WattRex/Regenerative-Battery-Cycler/doc/Sys_requirements.xlsm

Sheet: Info
Document Info
Internal project name | EPC - Electronic Power Converter for battery cycling
Filename | Sys_requirements_v7
Owner | Pablo Pastor
Review date | 2023-05-30
Review history | V6: - First versions from @Iulian in spanish translated and reviewed - Interal links between SYS // SW // HW Reqs added V7: - SW_reqs initialized - Registers included - SYS026 HS min value changed to 5v4 - SYS041, SYS042 changed to -15, 65 ºC - SYS045, SYS046 changed to -15, 65 ºC - SYS049, SYS050 changed to -15, 65 ºC - SYS043, SYS047, SYS051 changed to +-0.5 - resolution changed to accuracy - limit for wait only time

Sheet: Acronyms
Acronyms definition
EPC | Electronic Power Converter
HS | High Side (Input of the EPC with higher voltage)
LS | Low Side (Input of the EPC with lower voltage)
DUT | Device Under Test (Battery connected in LS)
SOA | Safe Operative Area

Sheet: SYS_Req
Requirement list
 |  |  |  |  |  |  | Category List | Functional | Technical | Operational | KPI | Transitional
Category | ID | Req. Description | Category | Priority | Test or verification | Derivated | Priority list | Must have | Should have | Could have | Won't have
General | SYS001 | The main target besides all the technical and functional requirements descripted here is the lowest cost possible | KPI | Must have |  | ,
General | SYS002 | The device is able to charge and discharge a DUT connected to the LS of the EPC | Functional | Must have
General | SYS003 | The electronics in the EPC powers from the HS input power system | Technical | Must have |  | ,
General | SYS004 | The stand-by power consumtion is lower than XXX mW | Technical | Must have |  | ,
General | SYS005 | The efficiency of the EPC goes up to XXX % | Technical | Must have
General | SYS006 | The EPC follows a bidirectional synchronous buck topology | Technical | Must have | - | ,
Mechanical | SYS007 | The EPC should fit in a box with maximum dimensions of 15x15x5 cm | Functional | Must have | - | ,
Mechanical | SYS008 | The EPCs must be interconectable to stack mechanically several devices (up to, at least, 10) | Functional | Must have |  | ,
Mechanical | SYS009 | The EPC has different DUT ports models (battery holder and external). This must lead to few changes in the construction of the device | Functional | Must have
Mechanical | SYS010 | The EPC has a 18650 battery holder to connect the DUT | Functional | Must have |  | ,
Mechanical | SYS011 | The EPC has a banana plug to connect external DUT | Functional | Could have |  | ,
Measures | SYS012 | The EPC has an external voltage measurement conector to sense voltage with a 4 point probe | Functional | Must have |  | ,
Measures | SYS013 | The EPC has an external NTC probe to measure ambient temperature | Functional | Must have |  | ,
Measures | SYS014 | The EPC has an external NTC probe in the anode of the 18650 battery holder | Functional | Must have |  | ,
Measures | SYS015 | The EPC has an integrated temperature probe in the body of the 18650 battery holder | Functional | Must have |  | ,
Measures | SYS016 | The EPC has an external NTC probe to measure the external DUT temperature | Functional | Could have |  | ,
Measures | SYS017 | The external NTC probe for the anode could be moved to the anode of an external DUT | Functional | Could have |  | ,
Measures | SYS018 | The EPC measures HS voltage | Functional | Must have |  | ,
Measures | SYS019 | The EPC measures LS voltage | Functional | Must have |  | ,
Measures | SYS020 | The EPC measures LS current | Functional | Must have |  | ,
Measures | SYS021 | The measurement of the LS voltage is allways made via a 4 points system (in battery holder as well as in external batteries) | Technical | Must have |  | ,
Measures | SYS022 | The system monitorizes internal temperature to avoid over temperature while working | Technical | Must have |  | ,
HS V def | SYS023 | The maximum limit to measure HS voltage is 15 V | Technical | Must have |  | ,
HS V def | SYS024 | The minimum limit to measure HS voltage is 0 V | Technical | Must have |  | ,
HS V def | SYS025 | The maximum operative voltage in HS (overvoltage alarm) is 14 V | Technical | Must have |  | SW001,
HS V def | SYS026 | The minimum operative voltage in HS (undervoltage alarm) is 5.4 V | Technical | Must have |  | SW001,
HS V def | SYS027 | The accuracy in the HS voltage measurement is ± 5 mV | Technical | Must have |  | ,
HS V def | SYS028 | The sampling rate for the HS voltage signal is 100 kHz (10 us) | Technical | Must have |  | ,
LS V def | SYS029 | The maximum limit to measure LS voltage is 6 V | Technical | Must have |  | ,
LS V def | SYS030 | The minimum limit to measure LS voltage is 0 V | Technical | Must have |  | ,
LS V def | SYS031 | The maximum operative voltage in LS (overvoltage alarm) is 5 V | Technical | Must have |  | SW002,
LS V def | SYS032 | The minimum operative voltage in LS (undervoltage alarm) is 0.5 V | Technical | Must have |  | SW002,
LS V def | SYS033 | The accuracy in the LS voltage measurement is ± 5 mV | Technical | Must have |  | ,
LS V def | SYS034 | The sampling rate for the LS voltage signal is 100 kHz (10 us) | Technical | Must have |  | ,
LS I def | SYS035 | The maximum limit to measure LS current is +16.5 A | Technical | Must have |  | ,
LS I def | SYS036 | The minimum limit to measure LS current is -16.5 A | Technical | Must have |  | ,
LS I def | SYS037 | The maximum controlable current in LS (control limit) is 15 A | Technical | Must have |  | SW003,
LS I def | SYS038 | The minimum controlable current in LS (control limit) is -15 A | Technical | Must have |  | SW003,
LS I def | SYS039 | The accuracy in the LS current measurement is ± 10 mA | Technical | Must have |  | ,
LS I def | SYS040 | The sampling rate for the LS current signal is 100 kHz (10 us) | Technical | Must have |  | ,
Temp amb | SYS041 | The maximum limit to measure ambient temperature is +65 ºC | Technical | Must have |  | SW004,
Temp amb | SYS042 | The minimum limit to measure ambient temperature is -15 ºC | Technical | Must have |  | SW004,
Temp amb | SYS043 | The accuracy in the ambient temperature is ± 0.5 ºC | Technical | Should have |  | ,
Temp amb | SYS044 | The sampling rate for the ambient temperature signal is 1 Hz (1 s) | Technical | Must have |  | ,
Temp body | SYS045 | The maximum limit to measure body temperature is +65 ºC | Technical | Must have |  | ,
Temp body | SYS046 | The minimum limit to measure body temperature is -15 ºC | Technical | Must have |  | ,
Temp body | SYS047 | The accuracy in the body temperature is ± 0.5 ºC | Technical | Should have |  | ,
Temp body | SYS048 | The sampling rate for the body temperature signal is 1 Hz (1 s) | Technical | Must have |  | ,
Temp anode | SYS049 | The maximum limit to measure anode temperature is +65 ºC | Technical | Must have |  | SW005,
Temp anode | SYS050 | The minimum limit to measure anode temperature is -15 ºC | Technical | Must have |  | SW005,
Temp anode | SYS051 | The accuracy in the anode temperature is ± 0.5 ºC | Technical | Should have |  | ,
Temp anode | SYS052 | The sampling rate for the anode temperature signal is 1 Hz (1 s) | Technical | Could have |  | ,
Control | SYS053 | The EPC has a control mode in current of LS: CC | Functional | Must have |  | ,
Control | SYS054 | The EPC has a control mode in voltage of LS: CV | Functional | Must have |  | ,
Control | SYS055 | The EPC has a control mode in power of LS: CP | Functional | Must have |  | ,
Control | SYS056 | The EPC has a control mode disabling the DMOS, with zero current in LS: WAIT | Functional | Must have |  | ,
Control | SYS057 | The EPC will apply the reference if the output is enabled until the setted limit is reached, the output is disabled or a new reference value is applied | Functional | Must have
Control | SYS058 | When the limit is reached or the output is disabled, the new defauls state will be IDLE
Control | SYS059 | The minimum control step for the reference and limit values are 1 mA // mV // dW // ms | Functional | Must have |  | ,
Control | SYS060 | The current reference range is the same as the controlable current range | Functional | Must have |  | ,
Control | SYS061 | The voltage reference range is the same as the operative LS voltage | Functional | Must have |  | ,
Control | SYS062 | Time limit reference minimum value is 1 ms
Control | SYS063 | Time limit reference maximum value is 4294967295 ms (3 days)
Control | SYS064 | Time limit reference resolution is 1 ms
Control | SYS065 | The power reference range is ± 50 W | Functional | Must have |  | ,
Control | SYS066 | The SOA is defined by the maximum and minimum controlable LS current and operative LS voltage | Functional | Must have |  | ,
Control | SYS067 | If reference exceeds SOA, the reference will be limited to be in the SOA | Functional | Must have |  | ,
Control | SYS068 | The maximum LS current ripple in best case scenario is ± 10 mA | Functional | Should have |  | ,
Control | SYS069 | The maximum LS voltage ripple in best case scenario is ± 10 mV | Functional | Should have |  | ,
Control | SYS070 | The maximum LS power ripple in best case scenario is ± 5 mW | Functional | Must have |  | ,
Control | SYS071 | The maximum response time in best case scenario is 1 ms (1 kHz) | Functional | Must have |  | ,
Control | SYS072 | The maximum response time is 10 ms (100 Hz) | Functional | Must have |  | ,
Control | SYS073 | The possible limits for voltage control mode are time, current or power | Functional | Must have |  | ,
Control | SYS074 | The possible limits for current control mode are time, voltage or power | Functional | Must have |  | ,
Control | SYS075 | The possible limits for power control mode are time, current or voltage | Functional | Must have |  | ,
Control | SYS076 | The possible limit for wait mode is only time | Functional | Must have |  | ,
Control | SYS077 | Enable signal, mode, reference, limit and limit reference are send together | Functional | Must have |  | SW008,
Interface | SYS078 | The EPC has a CAN bus communication system | Technical | Must have |  | ,
Interface | SYS079 | The EPC has several LEDs to indicate function mode and errors | Functional | Should have |  | ,
Interface | SYS080 | Each mode and error has a different combination of LEDs blinks to be identified | Functional | Should have
Interface | SYS081 | The user will set the output (enable or disable) via CAN | Functional | Must have |  | ,
Interface | SYS082 | The user will set the control mode via CAN | Functional | Must have |  | ,
Interface | SYS083 | To each message without response request, the EPC will response with the register updated to check signal integrity, if there is an error in the message the values won´t be updated. | Functional | Must have
Limits | SYS084 | The user can change the software alarms for LS maximum voltage between the operative range via CAN | Functional | Must have |  | ,
Limits | SYS085 | The user can change the software alarms for LS minimum voltage between the operative range via CAN | Functional | Must have |  | ,
Limits | SYS086 | The user can change the software alarms for LS maximum current between the controlable range via CAN | Functional | Must have |  | ,
Limits | SYS087 | The user can change the software alarms for LS minimum current between the controlable range via CAN | Functional | Must have |  | ,
Limits | SYS088 | The user can change the software alarms for HS maximum voltage between the operative range via CAN | Functional | Must have |  | ,
Limits | SYS089 | The user can change the software alarms for HS minimum voltage between the operative range via CAN | Functional | Must have |  | ,
Limits | SYS090 | The user can change the software alarms for HS maximum current between the controlable range via CAN | Functional | Could have |  | SW006,
Limits | SYS091 | The user can change the software alarms for HS minimum current between the controlable range via CAN | Functional | Could have |  | SW006,
Limits | SYS092 | The user can change the software alarms for LS maximum power between the operative range via CAN | Functional | Must have |  | ,
Limits | SYS093 | The user can change the software alarms for LS minimum power between the operative range via CAN | Functional | Must have
Limits | SYS094 | The user can change the software alarms for maximum temperature (in any temperature sensor) | Functional | Must have
Limits | SYS095 | The user can change the software alarms for minimum temperature (in any temperature sensor) | Functional | Must have |  | ,
Limits | SYS096 | The user can ask for every limit to check its actual value | Functional | Must have
Msg req | SYS097 | The user can request the device ID to the device via CAN | Functional | Should have
Msg req | SYS098 | The user can request the firmware version to the device via CAN | Functional | Should have
Msg req | SYS099 | The user can request the hardware version to the device via CAN | Functional | Should have
Msg req | SYS100 | The user can request the LS Voltage via CAN | Functional | Must have
Msg req | SYS101 | The user can request the LS Current via CAN | Functional | Must have
Msg req | SYS102 | The user can request the HS Voltage via CAN | Functional | Must have
Msg req | SYS103 | The user can request the Body temperature via CAN | Functional | Must have
Msg req | SYS104 | The user can request the Anode temperature via CAN | Functional | Must have
Msg req | SYS105 | The user can request the Ambient temperature via CAN | Functional | Must have
Periodic msg | SYS106 | The user can enable or disable a heart beat message (from the user to the EPC). If not received in the stablished period, it will disable the power flow | Functional | Must have
Periodic msg | SYS107 | The user can set the period of the heart beat message from the user to the EPC | Functional | Must have |  | ,
Periodic msg | SYS108 | The user can enable or disable a periodical request of the electrical variables | Functional | Must have |  | ,
Periodic msg | SYS109 | The user can set the period of the electrical variables message | Functional | Must have |  | ,
Periodic msg | SYS110 | The user can enable or disable a periodical request of the temperature variables | Functional | Must have |  | ,
Periodic msg | SYS111 | The user can set the period of the temperature variables message | Functional | Must have |  | ,
Error | SYS112 | The EPC has a LS current error detection: It detects LS current out of the controlable range and disable the output | Functional | Must have |  | ,
Error | SYS113 | The EPC has a LS voltage error detection: It detects LS voltage out of the operative range and disable the output | Functional | Must have |  | ,
Error | SYS114 | The EPC has a HS voltage error detection: It detects LS voltage out of the operative range and disable the output | Functional | Must have |  | ,
Error | SYS115 | The EPC has a temperature error detection: It detects temperature (in any sensor) out of the operative range and disable the output | Functional | Must have |  | ,
Error | SYS116 | The EPC has a communications error: It detects errors in the CAN bus. If the user heart beat is enabled and the heart beat is not sended in the stablished period, this error is rised & the output is disabled | Functional | Must have |  | ,
Error | SYS117 | The EPC has a internal error signal: Any internal error (temperature, devices status, software issues) will be detected and the output will be disabled | Functional | Must have |  | ,
Error | SYS118 | The EPC will send a message via CAN when any error is raised indicating the error type and error value | Functional | Must have |  | ,
Error | SYS119 | The EPC will set a binary code in the LEDs to indicate the error to the user | Functional | Should have |  | ,
Error | SYS120 | When any error is enabled, the device will not accept new references nor consign limits | Functional | Must have |  | ,
Error | SYS121 | Security limits can be changed in any error mode | Functional | Must have |  | ,
Control | SYS122 | The status after all errors are cleared will be IDLE without any consign | Functional | Must have |  | ,
Error | SYS123 | The HS voltage error will be cleared when the levels are back to the defined limit range | Functional | Must have |  | ,
Error | SYS124 | The LS voltage error will be cleared when the levels are back to the defined limit range | Functional | Must have |  | ,
Error | SYS125 | The LS current error will be cleared when the levels are back to the defined limit range | Functional | Must have |  | ,
Error | SYS126 | The temperature error will be cleared when the levels are back to the defined limit range | Functional | Must have |  | ,
Control | SYS127 | The internal error might be self-cleared if any internal routine is able to fix the issue. If not, the device must be power off and on | Functional | Must have |  | ,
Error | SYS128 | The communication error will be cleared when a user message is succesfully received | Functional | Must have |  | ,

Sheet: SW_Req
Requirement list
Category | ID | Related to | Req. Description | Affects | Derivated
Limits | SW001 | SYS025, SYS026 | Internal limit for limit range in HS voltage goes from [5.3 … 14.1] V to include max and min SYS defined values in range | - Limit ranges - Registers
Limits | SW002 | SYS031, SYS032 | Internal limit for limit range in LS voltage goes from [0.4 … 5.1] V to include max and min SYS defined values in range | - Limit ranges - Registers
Limits | SW003 | SYS037, SYS038 | Internal limit for limit range in LS current goes from [-15.1 … 15.1] A to include max and min SYS defined values in range | - Limit ranges - Registers
Limits | SW004 | SYS041, SYS042 | Internal limit for limit range in ambient temp goes from [-20 … 70] ºC to include max and min SYS defined values in range | - Limit ranges - Registers | HW001
Limits | SW005 | SYS049, SYS050 | Internal limit for limit range in anode temp goes from [-20 … 70] ºC to include max and min SYS defined values in range | - Limit ranges - Registers | HW001
Limits | SW006 | SYS090, SYS091 | Limits in HS Current WON'T BE IMPLEMENTED | - Limit ranges - Registers - CAN Messages
Error | SW007 | - | Watchdog reset uC after 0.5 ms if not hearbeat received | - APP_SALG - HAL_WDG
Interface | SW008 | SYS077 | The maximum response time for communication is 10 ms (100 Hz) | - APP_IFACE
 | SW009
 | SW010
 | SW011
 | SW012
 | SW013
 | SW014
 | SW015
 | SW016
 | SW017
 | SW018
 | SW019
 | SW020
 | SW021

Sheet: HW_Req
Requirement list
Category | ID | Related to | Req. Description | Affects | Derivated
Measures | HW001 | SYS041, SYS042, SYS049, SYS050, SW004, SW005 | Hardware limits to temperature measurements in ADC are [-20 … 70] ºC to have more software range | - NTC to 3v3 conversion
Power | HW002 | - | Fast blow fuse connected in positive input: - 10A continuous 2.7h to blow - 20A continuous 100ms to blow
Temp control | HW003 | - | Add a GPIO to a transistor to activate an external fan
 | HW004
 | HW005
 | HW006
 | HW007
 | HW008
 | HW009
 | HW010
 | HW011
 | HW012
 | HW013
 | HW014
 | HW015
 | HW016
 | HW017
 | HW018
 | HW019
 | HW020
 | HW021
 | HW022
 | HW023
 | HW024
 | HW025 |  | min -20
 | HW026 |  | max 70
 | HW027
 | HW028
 | HW029
 | HW030
 | HW031
 | HW032
 | HW033
 | HW034
 | HW035
 | HW036
 | HW037
 | HW038
 | HW039
 | HW040
 | HW041
 | HW042
 | HW043
 | HW044
 | HW045
 | HW046
 | HW047
 | HW048
 | HW049
 | HW050
 | HW051
 | HW052
 | HW053
 | HW054
 | HW055
 | HW056
 | HW057
 | HW058
 | HW059
 | HW060
 | HW061
 | HW062
 | HW063
 | HW064
 | HW065
 | HW066
 | HW067
 | HW068
 | HW069
 | HW070
 | HW071
 | HW072
Signals
 | From |  | Signal | Direction | Resolution | Resolution |  | Range
SG_SW001 | SYS007 |  | V_HS | Input | SYS029 | SYS029 | 4mV | SYS025,SYS026 | 7-15V
SG_SW002 | SYS008 |  | V_LS | Input | SYS034 | SYS034 | 1,5mV | SYS030,SYS031
SG_SW003 | SYS010 |  | I_LS | Input | SYS039 | SYS039 | 5,5mA | SYS037,SYS038
SG_SW004 | SYS011 |  | V_LS_ext | Input | SYS034 | SYS034 | 1,5mV | SYS030,SYS031
SG_SW005 | SYS012 |  | T_HS | Input | SYS017 | SYS017 | XXX bits | SYS015 | 15-55
SG_SW006 | SYS013 |  | T_LS_an | Input | SYS020 | SYS020 | XXX bits | SYS018 | 15-55
SG_SW007 | SYS021 |  | V_5v | Input
SG_SW008 | SYS004 |  | V_3v3 | Input
SG_SW009 | SYS014 |  | T_LS_bo | Input | SYS001 | SYS001 | XXX bits | SYS089 | 0-65
SG_SW010 | SYS022 |  | Led_1 | Output
SG_SW011 | SYS022 |  | Led_2 | Output
SG_SW012 | SYS022 |  | Led_3 | Output
SG_SW013 | SYS022 |  | Led_4 | Output
SG_SW014 | SYS046 |  | PWM | Output
Peripherals
PR_SW001 | SG_SW001-SG_SW004 |  | FADC
PR_SW002 | SG_SW005-SG_SW008 |  | ADC
PR_SW003 | SG_SW009 |  | I2C
PR_SW004 | SG_SW010-SG_SW013 |  | GPIO
PR_SW005 | #REF! |  | CAN
PR_SW006 | SG_SW001-SG_SW004 |  | DMA
PR_SW007 | SG_SW014 |  | PWM
PR_SW008 | PR_SW007 |  | HRTIM
PR_SW009 | #REF! |  | TIM_RT
PR_SW010 | SG_SW001-SG_SW004 |  | TIM_PWR_MEAS
PR_SW011 | SYS060-SYS065 |  | FLASH
Control modes
CM_SW001 | - |  | WAIT
CM_SW002 | #REF! |  | CTRL_I_LS
CM_SW003 | SYS053 |  | CTRL_V_LS
CM_SW004 | SYS054 |  | CTRL_PWR_LS
CM_SW005 | SYS055 |  | CTRL_I_PULSE_LS
Memory table
Registers
Modules
HAL_PWM | Input: duty & periferal Applies dutty to peripheral. - Enables PWM - Set duty
HAL_GPIO | - Set output leds - Enable DRMOS - Reads DRMOS temp warn - Reads Vstatus inputs
HAL_CAN | - Sends via CAN a premade payload & ID - Adds extended mode conf to msg - Reads incoming msgs - Set HW filters for incoming msgs
HAL_I2C | - Request and read temp sensor
HAL_TMR | Init: - Configures TIM_RT (10kHz) - Configures IRQ_TIM_RT - Configures HRTIM (1MHz) - Configures TIM_PWR_MEAS (100KHz) Start/Stop timer ()
HAL_ADC | - Configures normal ADCs (With regular range) - Configures FADC + TIMER + DMA<- CHECK IF A RANGE CAN BE MEASURED or ONLY INDIVIDUAL ADCs - Get meas () - RefreshMeas() - GetFastMeas()?? In DMA?? - Start/Stop FastMeas - GetFadcStatus()
HAL_DMA | - ConfigDMA(freq, mem…) - GetFastMeas()?? In ADC??
HAL_SYS | - Init peripherals - Watchdog - SysClockTree
MID_PWR | - Input: V_HS, V_LS - calculate_D0 (V_HS, V_LS) for I0 - setPwr(Status) -> changes DRMOS enable pin - currentPi (D0, I_ref, I_LS) : applies duty to PWM - voltagePi (V_ref, V_LS) -> I_ref - powerPi (V_ref, V_LS) -> I_ref
MID_DABS | - GetMeas() -> updates registers. Avg fast ADC. Get ADC & Get I2C - UpdateLeds() mini status machine
MID_COMM | - Parsers payload depending on msg type - Invoke to IFACE protocol callbacks - Sends outcoming msg (ID, data <- uint8 array)
APP_CTRL | - Reads mode and ref and manages to apply - Manages errors depending temperature - Manages errors depending V & I - setCtrl -> enables Pis and errors management IS ABLE TO READ REGISTERS
APP_SALG | - Inits system (HAL_SYS) - GetMeas (MID_DABS) - GetNewMsgs(APP_IFACE) - ApplyControl(APP_CTRL) - UpdateLeds(MID_DABS) - SendMsgs(APP_IFACE)
APP_IFACE | - GetNewMsgs(MID_COMM) - Implements protocol callbacks for incoming msgs - Validates incoming values and raises errors - Sends applied configuration after reading incoming msg - Write incoming registers - Sends outcoming msgs depending on configured periodicity - Raises ACK timeout error

Sheet: SW_Arch
Signals
 | From | Signal | Direction | Resolution |  | Range
SG_SW001 | SYS007 | V_HS | Input | SYS029 | 4mV | SYS025,SYS026 | 7-15V
SG_SW002 | SYS008 | V_LS | Input | SYS034 | 1,5mV | SYS030,SYS031
SG_SW003 | SYS010 | I_LS | Input | SYS039 | 5,5mA | SYS037,SYS038
SG_SW004 | SYS011 | V_LS_ext | Input | SYS034 | 1,5mV | SYS030,SYS031
SG_SW005 | SYS012 | T_HS | Input | SYS017 | XXX bits | SYS015 | 15-55
SG_SW006 | SYS013 | T_LS_an | Input | SYS020 | XXX bits | SYS018 | 15-55
SG_SW007 | SYS021 | V_5v | Input
SG_SW008 | SYS004 | V_3v3 | Input
SG_SW009 | SYS014 | T_LS_bo | Input | SYS001 | XXX bits | SYS089 | 0-65
SG_SW010 | SYS022 | Led_1 | Output
SG_SW011 | SYS022 | Led_2 | Output
SG_SW012 | SYS022 | Led_3 | Output
SG_SW013 | SYS022 | Led_4 | Output
SG_SW014 | SYS046 | PWM | Output
Peripherals
PR_SW001 | SG_SW001-SG_SW004 | FADC
PR_SW002 | SG_SW005-SG_SW008 | ADC
PR_SW003 | SG_SW009 | I2C
PR_SW004 | SG_SW010-SG_SW013 | GPIO
PR_SW005 | #REF! | CAN
PR_SW006 | SG_SW001-SG_SW004 | DMA
PR_SW007 | SG_SW014 | PWM
PR_SW008 | PR_SW007 | HRTIM
PR_SW009 | #REF! | TIM_RT
PR_SW010 | SG_SW001-SG_SW004 | TIM_PWR_MEAS
PR_SW011 | SYS060-SYS065 | FLASH
Control modes
CM_SW001 | - | WAIT
CM_SW002 | #REF! | CTRL_I_LS
CM_SW003 | SYS053 | CTRL_V_LS
CM_SW004 | SYS054 | CTRL_PWR_LS
CM_SW005 | SYS055 | CTRL_I_PULSE_LS
Memory table
Registers
Modules
HAL_PWM | Input: duty & periferal Applies dutty to peripheral. - Enables PWM - Set duty
HAL_GPIO | - Set output leds - Enable DRMOS - Reads DRMOS temp warn - Reads Vstatus inputs
HAL_CAN | - Sends via CAN a premade payload & ID - Adds extended mode conf to msg - Reads incoming msgs - Set HW filters for incoming msgs
HAL_I2C | - Request and read temp sensor
HAL_TMR | Init: - Configures TIM_RT (10kHz) - Configures IRQ_TIM_RT - Configures HRTIM (1MHz) - Configures TIM_PWR_MEAS (100KHz) Start/Stop timer ()
HAL_ADC | - Configures normal ADCs (With regular range) - Configures FADC + TIMER + DMA<- CHECK IF A RANGE CAN BE MEASURED or ONLY INDIVIDUAL ADCs - Get meas () - RefreshMeas() - GetFastMeas()?? In DMA?? - Start/Stop FastMeas - GetFadcStatus()
HAL_DMA | - ConfigDMA(freq, mem…) - GetFastMeas()?? In ADC??
HAL_SYS | - Init peripherals - Watchdog - SysClockTree
MID_PWR | - Input: V_HS, V_LS - calculate_D0 (V_HS, V_LS) for I0 - setPwr(Status en, dis) -> changes DRMOS enable pin - voltagePi (V_ref, V_LS, I_LS) -> I_ref - currentPi (I_ref, V_LS, I_LS) : applies duty to PWM - voltagePi (V_ref, V_LS, I_LS) -> I_ref - powerPi (P_ref, V_LS, I_LS) -> I_ref
MID_DABS | - GetMeas() -> updates registers. Avg fast ADC. Get ADC & Get I2C - UpdateLeds() mini status machine
MID_COMM | - Parsers payload depending on msg type - Invoke to IFACE protocol callbacks - Sends outcoming msg (ID, data <- uint8 array)
APP_CTRL | - Reads mode and ref and manages to apply - Manages errors depending temperature - Manages errors depending V & I - setCtrl -> enables Pis and errors management IS ABLE TO READ REGISTERS
APP_SALG | - Inits system (HAL_SYS) - GetMeas (MID_DABS) - GetNewMsgs(APP_IFACE) - ApplyControl(APP_CTRL) - UpdateLeds(MID_DABS) - SendMsgs(APP_IFACE)
APP_IFACE | - GetNewMsgs(MID_COMM) - Implements protocol callbacks for incoming msgs - Validates incoming values and raises errors - Sends applied configuration after reading incoming msg - Write incoming registers - Sends outcoming msgs depending on configured periodicity - Raises ACK timeout error

Sheet: Naming_Convention
Project Naming Convention
Element Name | Alias (3 letters) | Component Name | Alias (4 letters max) | Prefix Layer | Prefix Component | Interface Components (*) | File | Global Macros | Local Macros | Global Typedefs (t) ** | Local Typedefs (t) ** | Global Functions | Local Functions
Application | APP | System Algorithms | Salg | APP | APP_SALG | APP_SALG_P_IF | app_salg | APP_SALG_XXXX | Salg_XXXX | APP_SALG_xxxx_xxxx_t | xxxx_xxxx_t | APP_SalgXxxx() | Xxxx()
 |  | Interface | Iface | APP | APP_IFACE | APP_IFACE_P_IF | app_iface | APP_IFACE_XXXX | Iface_XXXX | APP_IFACE_xxxx_xxxx_t | xxxx_xxxx_t | APP_IfaceXxxx() | Xxxx()
 |  | Control | Ctrl | APP | APP_CTRL | APP_CTRL_P_IF | app_ctrl | APP_CTRL_XXXX | Ctrl_XXXX | APP_CTRL_xxxx_xxxx_t | xxxx_xxxx_t | APP_CtrlXxxx() | Xxxx()
Middleware | MID | Power | Pwr | MID | MID_PWR | MID_PWR_P_IF | mid_pwr | MID_PWR_XXXX | Pwr_XXXX | MID_PWR_xxxx_xxxx_t | xxxx_xxxx_t | MID_PwrXxxx() | Xxxx()
 |  | Device Abstraction | Dabs | MID | MID_DABS | MID_DABS_P_IF | mid_dabs | MID_DABS_XXXX | Dabs_XXXX | MID_DABS_xxxx_xxxx_t | xxxx_xxxx_t | MID_DabsXxxx() | Xxxx()
 |  | Communications | Comm | MID | MID_COMM | MID_COMM_P_IF | mid_comm | MID_COMM_XXXX | Comm_XXXX | MID_COMM_xxxx_xxxx_t | xxxx_xxxx_t | MID_CommXxxx() | Xxxx()
Harware Abstraction | HAL | Pwm | Pwm | HAL | HAL_PWM | HAL_PWM_P_IF | hal_pwm | HAL_PWM_XXXX | Pwm_XXXX | HAL_PWM_xxxx_xxxx_t | xxxx_xxxx_t | HAL_PwmXxxx() | Xxxx()
 |  | Input outputs | Gpio | HAL | HAL_GPIO | HAL_GPIO_P_IF | hal_gpio | HAL_GPIO_XXXX | Gpio_XXXX | HAL_GPIO_xxxx_xxxx_t | xxxx_xxxx_t | HAL_GpioXxxx() | Xxxx()
 |  | Analog conversion | Adc | HAL | HAL_ADC | HAL_ADC_P_IF | hal_adc | HAL_ADC_XXXX | Adc_XXXX | HAL_ADC_xxxx_xxxx_t | xxxx_xxxx_t | HAL_AdcXxxx() | Xxxx()
 |  | Comm I2C | I2c | HAL | HAL_I2C | HAL_I2C_P_IF | hal_i2c | HAL_I2C_XXXX | I2c_XXXX | HAL_I2C_xxxx_xxxx_t | xxxx_xxxx_t | HAL_I2cXxxx() | Xxxx()
 |  | Direct memmory access | Dma | HAL | HAL_DMA | HAL_DMA_P_IF | hal_dma | HAL_DMA_XXXX | Dma_XXXX | HAL_DMA_xxxx_xxxx_t | xxxx_xxxx_t | HAL_DmaXxxx() | Xxxx()
 |  | Timers | Tmr | HAL | HAL_TMR | HAL_TMR_P_IF | hal_tmr | HAL_TMR_XXXX | Tmr_XXXX | HAL_TMR_xxxx_xxxx_t | xxxx_xxxx_t | HAL_TmrXxxx() | Xxxx()
 |  | System | Sys | HAL | HAL_SYS | HAL_SYS_P_IF | hal_sys | HAL_SYS_XXXX | Sys_XXXX | HAL_SYS_xxxx_xxxx_t | xxxx_xxxx_t | HAL_SysXxxx() | Xxxx()
 |  | Watchdog | Wdg | HAL | HAL_WDG | HAL_WDG_P_IF | hal_wdg | HAL_WDG_XXXX | Wdg_XXXX | HAL_WDG_xxxx_xxxx_t | xxxx_xxxx_t | HAL_WdgXxxx() | Xxxx()
 |  | Comm CAN | Can | HAL | HAL_CAN | HAL_CAN_P_IF | hal_can | HAL_CAN_XXXX | Can_XXXX | HAL_CAN_xxxx_xxxx_t | xxxx_xxxx_t | HAL_CanXxxx() | Xxxx()
* The interfaces will have P or R depending on if they are provided or required
** The Global and Local Typedefs name has a "t" at the end. Enums, unions and structs have the same name but instead a "t" they have "e", "u", "s".

Sheet: IO
Name |  | Signal | Direction (uC) | Peripheral | PIN | SIGNAL_NAME
DRMOS | FDMF6820C | Out_Disable | Out | GPIO | PA9 (42) | HAL_GPIO_Out_Disable
 |  | Pwm_Out | Out | PWM_HRTIM1_ChA1 | PA8 (41) | HAL_PWM_Out
 |  | Thermal_Warn | In | GPIO | PA10 (43) | HAL_GPIO_Thermal_Warn
CAN | MAX3059ASA | Tx | Out | CAN | PA12 (45) | CAN_Tx
 |  | Rx | In | CAN | PA11 (44) | CAN_Rx
LED |  | Led0 | Out | GPIO | PC4 (24) | HAL_GPIO_Led0
 |  | Led1 | Out | GPIO | PC5 (25) | HAL_GPIO_Led1
 |  | Led2 | Out | GPIO | PB0 (26) | HAL_GPIO_Led2
 |  | Led3 | Out | GPIO | PB1 (26) | HAL_GPIO_Led3
Current Sense | INA181A2 | Ls_Curr | In | FADC2, IN1 | PA4 (20) | HAL_ADC_Ls_Curr
Voltage Sense | TVS7721 | Ls_Volt | In | FADC2, IN2 | PA5 (21) | HAL_ADC_Ls_Volt
 |  | Hs_Volt | In | FADC2, IN4 | PA7 (23) | HAL_ADC_Hs_Volt | IDEA DE MARIUS
DC/DC 3v3 | RT7251 | Status_3v3 | In | GPIO | PB14 (35) | HAL_GPIO_Status_3v3
DC/DC 5v0 | RT7251 | Status_5v0 | In | GPIO | PB15 (36) | HAL_GPIO_Status_5v0
NTC | LM224APT | Temp_Anod | In | ADC1, IN2 | PA1 (15) | HAL_ADC_TEMP_ANOD
NTC | LM224APT | Temp_Amb | In | ADC1, IN1 | PA0 (14) | HAL_ADC_TEMP_AMB
 |  | Int_Temp | In | ADC1, IN3 |  | HAL_ADC_INT_TEMP
Body temp | STS30-DIS | SDA | In/Out | I2C | PB7 (59) | I2C1_SDA
 |  | SCL | Out | I2C | PB6 (58) | I2C1_SCL
JTAG |  | NJTRST | Out | JTAG | PB4 (56) | SYS_NJTRST
 |  | JTDO | Out | JTAG | PB3 (55) | SYS_JTDO-TRACESWO
 |  | JTDI | In | JTAG | PA15 (50) | SYS_JTDI
 |  | JTCK | In | JTAG | PA14 (49) | SYS_JTCK-SWCLK
 |  | JTMS | - | JTAG | PA13 (46) | SYS_JTMS-SWDIO

Sheet: Registers
Internal registers definition (MID_REG) |  |  |  |  |  |  |  |  |  | Instances of internal registers
Category | Name | Description | Type | Start bit | Bit lenght | Scaling | Min | Max | Default | Variable Name | Read Modules | Write Modules | Definition Module
Limit: MID_REG_limit_range MID_REG_limit | lsVoltMax | max value for the LsVolt variable | uint16_t | 0 | 16 | mV | 400 | 5100 | 5100 | EPC_CONF_limit_range | APP_IFACE | -- | EPC_CONF | X
 | lsVoltMin | min value for the LsVolt variable | uint16_t | 16 | 16 | mV | 400 | 5100 | 400 | APP_SALG_limit | APP_CTRL APP_IFACE MID_PWR | APP_IFACE | APP_SALG | X
 | lsCurrMax | max value for the LsCurr variable | int16_t | 32 | 16 | mV | -15500 | 15500 | 15500 | APP_SALG_consign | APP_SALG APP_CTRL | APP_IFACE | APP_SALG | X
 | lsCurrMin | min value for the LsCurr variable | int16_t | 48 | 16 | mV | -15500 | 15500 | -15500 | APP_SALG_control | APP_IFACE MID_DABS APP_CTRL | APP_CTRL | APP_SALG | X
 | hsVoltMax | max value for the HsVolt variable | uint16_t | 64 | 16 | mV | 5300 | 14100 | 14100 | EPC_CONF_periodic_time_min | APP_IFACE | -- | EPC_CONF | X
 | hsVoltMin | min value for the HsVolt variable | uint16_t | 80 | 16 | mV | 5300 | 14100 | 5300 | APP_IFACE_periodic | APP_IFACE | APP_IFACE | APP_IFACE | X
 | lsPwrMax | max value for the LsPwr variable | int16_t | 96 | 16 | dW (W x 10) | -800 | 800 | 510 | EPC_CONF_info | MID_DABS APP_IFACE | -- | EPC_CONF | X
 | lsPwrMin | min value for the LsPwr variable | int16_t | 112 | 16 | dW (W x 10) | -800 | 800 | -510 | APP_SALG_errorStatus | APP_SALG MID_DABS APP_IFACE APP_CTRL | APP_CTRL APP_SALG | APP_SALG | X
 | tempMax | max value for the Temperature variables | int16_t | 128 | 16 | dºC | -200 | 700 | 660 | APP_SALG_meas_s | APP_CTRL APP_IFACE | MID_DABS | APP_SALG | X
 | tempMin | min value for the Temperature variables | int16_t | 144 | 16 | dºC | -200 | 700 | -160
Control: MID_REG_control MID_REG_consign | outStatus | Status of pwr conversion | Bit field uint_8 | 0 | 1 | - | 0 = Disabled 1 = Enabled |  | 0
 | mode | Control type |  | 1 | 3 | - | 0 = WAIT 1 = Voltage control mode (CV) 2 = Current control mode (CC) 3 = Power control mode (CP) 4 = IDLE 5 = ERROR |  | 0
 | limitType | Limit type for control type |  | 4 | 3 | - | 0 = Time 1 = Volt 2 = Curr 3 = Pwr |  | 0
 | modeRef | Reference for the control type | int16_t | 16 | 16 | mA/mV/dW | - | - | 0
 | limRef | Reference for the limit type | int32_t | 32 | 32 | mA/mV/dW/ms | - | - | 0
Periodic: MID_REG_periodic_time_min MID_REG_periodic | usrHeartBeatStatus | Status for the usrHeartBeat msg | Bit | 0 | 1 | - | 0 = Disabled 1 = Enabled |  | 0
 | usrHeartBeatPeriod | Periodicity for the user heart beat signal | uint16_t | 1 | 15 | ms | 10 | 65535 | 1000 |  |  |  | Bit field uint8_t
 | electricMsgStatus | Status for the periodical electrical measures msg | Bit | 16 | 1 | - | 0 = Disabled 1 = Enabled |  | 0
 | electricMsgPeriod | Periodicity for the electric measures msg | uint16_t | 17 | 15 | ms | 10 | 65535 | 1000
 | tempMsgStatus | Status for the usrHeartBeat msg | Bit | 32 | 1 | - | 0 = Disabled 1 = Enabled |  | 0
 | tempMsgPeriod | Periodicity for the temp measures msg | uint16_t | 33 | 15 | ms | 10 | 65535 | 1000
Info: MID_REG_info | id | Id. Used for CAN | Bit field uint32_t | 0 | 6 | - | 0 | 63 | -
 | fwVer | Flashed fw version |  | 6 | 5 | - | 0 | 31 | -
 | hwVer | Board version |  | 11 | 13 | - | 0 | 8191 | -
 | sn | Board S/N |  | 25 | 8 | - | 0 | 255 | -
Error MID_REG_errorStatus | hsVoltErr | Error in hsVolt variable | Bit field uint8_t | 0 | 1 | - | 0 = No error 1 = Error |  | 0
 | lsVoltErr | Error in lsVolt variable |  | 1 | 1 | - | 0 = No error 1 = Error |  | 0
 | lsCurrErr | Error in lsCurr variable |  | 2 | 1 | - | 0 = No error 1 = Error |  | 0
 | commErr | Error in communications or heart beat |  | 3 | 1 | - | 0 = No error 1 = Error |  | 0
 | tempErr | Error in temp variables |  | 4 | 1 | - | 0 = No error 1 = Error |  | 0
 | intErr | Any internal error |  | 5 | 1 | - | 0 = No error 1 = Error |  | 0
 | lastErrVal | Last error value | uint16_t | 0 | 16 | - | - | - | 0
Meas | lsVolt | LS voltage measure | uint16_t | 0 | 16 | mV | 0 | 6000 | -
 | lsCurr | LS current measure | int16_t | 0 | 16 | mA | -16500 | 16500 | -
 | hsVolt | HS voltage measure | uint16_t | 0 | 16 | mV | 0 | 15000 | -
 | tempBody | Temp body measure | int16_t | 0 | 16 | dºC | -200 | 700 | -
 | tempAnod | Temp anode measure | int16_t | 0 | 16 | dºC | -200 | 700 | -
 | tempAmb | Temp ambient measure | int16_t | 0 | 16 | dºC | -200 | 700 | -

Sheet: Messages to EPC
Messages to EPC
 |  |  |  |  |  |  |  | Min | Max
 | EPC Set working mode; Message ID: 0xYY0 |  |  |  |  |  | YY is the EPC identificator | 0 | 100 | If Ack is enabled on register Config, each message is responded from EPC with the applied data
 | Variable Name | Start bit | Bit length | Scaling | Type | Description |  | 0x00 | 0x64
 | Enabled | 0 | 1 | - | - | This signal enabled/disables the EPC. 0 = EPC control disabled 1 = EPC control enabled Default value: 0 | Controller CAN identificar | 101 | 128
 | Mode | 1 | 3 | - | - | Used control mode: 0 = WAIT 1 = Voltage control mode (CV) 2 = Current control mode (CC) 3 = Power control mode (CP) Default value: 0 |  | 0x65 | 0x80
 | Limit Type | 4 | 3 | - | - | Type of the finish condition used for control. Available condition types: 0 = TIME: the mode ends when the time specified by the limit value has elapsed (ms). 1 = VOLTAGE: If not in CV mode, the cycle ends when the voltage indicated by the limit value is reached (mV). 2 = CURRENT: If not in CC mode, the cycle ends when the current indicated by the limit value is reached (mA). 3 = POWER: If not in CW mode, the cycle ends when the voltage indicated by the limit value is reached (mW).
 | Set point | 16 | 16 | mA/mV/dW | signed | Refrence value used to apply control modes. Desired value (voltage, current and power) to reach on each control mode.
 | Limit value | 32 | 32 | mA/mV/dW/ms | signed | Limit value used as stop condition (ms, mV, mA, mW)
 | EPC Request data; Message ID: 0xYY1
 | Variable Name | Start bit | Bit length | Scaling | Type | Description
 | Request info | 0 | 8 | - | - | Request data messages. 0 = Request info register, message with ID 0xYYA 1 = Request control register, message with ID 0xYY0 2 = Request status register and error value register, message with ID 0xYYB 3 = Request electrical measures registers, message with ID 0xYYC 4 = Request temperature measures registers, message with ID 0xYYD 5 = Void request, for ACK 6 = Request LS Voltage limits configuration, message with ID 7 = Request LS Current limits configuration, message with ID 8 = Request HS Voltage limits configuration, message with ID 9 = Request Power limits configuration, message with ID A = Request Temperature limits configuration, message with ID
 | EPC LS Voltage limits configuration; Message ID: 0xYY2
 | Variable Name | Start bit | Bit length | Scaling | Type | Description
 | LS Voltage Max | 0 | 16 | mV | signed | If LS voltage goes above it, device is disabled and LS Voltage error is raise.
 | LS Voltage Min | 16 | 32 | mV | signed | If LS voltage goes below it, device is disabled and LS Voltage error is raise.
 | EPC LS Current limits configuration; Message ID: 0xYY3
 | Variable Name | Start bit | Bit length | Scaling | Type | Description
 | LS Current Max | 0 | 16 | mV | signed | If LS current goes above it, device is disabled and LS Current error is raise.
 | LS Current Min | 16 | 32 | mV | signed | If LS current goes below it, device is disabled and LS Current error is raise.
 | EPC HS Voltage limits configuration; Message ID: 0xYY4
 | Variable Name | Start bit | Bit length | Scaling | Type | Description
 | HS Voltage Max | 0 | 16 | mV | signed | If HS voltage goes above it, device is disabled and HS Voltage error is raise.
 | HS Voltage Min | 16 | 32 | mV | signed | If HS voltage goes below it, device is disabled and HS Voltage error is raise.
 | EPC Power limits configuration; Message ID: 0xYY5
 | Variable Name | Start bit | Bit length | Scaling | Type | Description
 | Power Charge Max | 0 | 16 | mV | signed | If HS current goes above it, device is disabled and HS Current error is raise.
 | Power Discharge Min | 16 | 32 | mV | signed | If HS current goes below it, device is disabled and HS Current error is raise.
 | EPC Temperature limits configuration; Message ID: 0xYY6
 | Variable Name | Start bit | Bit length | Scaling | Type | Description
 | Temperature Max | 0 | 16 | mºC | signed | If any temperature sensor goes above it, device is disabled and Temperature error is raised.
 | Temperature Min | 16 | 32 | mºC | signed | If any temperature sensor goes below it, device is disabled and HS Current error is raised.
 | EPC Response configuration; Message ID: 0xYY7
 | Variable Name | Start bit | Bit length | Scaling | Type | Description
 | Enable user ACK | 0 | 1 |  |  | If 1, the EPC will require a message from the user on the defined period. If not received, it will disable the power flow
 | User ACK period | 1 | 15 | 10 ms | unsigned | Period used to receive life signal from the user
 | Enable electrical measures periodic message | 16 | 1 |  |  | If 1, enables the sending of electrical measures message
 | Electrical electrical measures period | 17 | 15 | 10 ms | unsigned | Period used to send electrical measures message.
 | Enable temperature periodic message | 32 | 1 |  |  | If 1, enables the sending of periodic temperatures message
 | Temperature period | 33 | 15 | 10 ms | unsigned | Period used to send temperatures message.

Sheet: Messages from EPC
Messages from EPC
 | EPC to external controller |  |  |  |  |  |  | Min | Max
 |  |  |  |  |  |  | YY is the EPC identificator | 0 | 100 | If Ack is enabled on register Config, each message is responded from EPC with the applied data
 |  |  |  |  |  |  |  | 0x00 | 0x64
 | EPC Info details; Message ID: 0xYYA |  |  |  |  |  | Controller CAN identificar | 101 | 128
 | Variable Name | Start bit | Bit length | Scaling | Type | Description |  | 0x65 | 0x80
 | Device id | 0 | 6 | - | - | Device identificator
 | Firmware version | 6 | 5 | - | - | Firmware version
 | Hardware version | 11 | 13 | - | - | Hardware version
 | Serial Number | 24 | 8 | - | - | Serial Number
 | EPC Status registers; Message ID: 0xYYB
 | Variable Name | Start bit | Bit length | Scaling | Type | Description
 | HS Voltage error (voltage out of limits) | 0 | 1 | - | - | 0 - No error detected 1 - Error raised due to voltage exceeds limits on HS
 | LS Voltage error (voltage out of limits) | 1 | 1 | - | - | 0 - No error detected 1 - Error raised due to voltage exceeds limits on LS
 | LS Current error (current of of limits) | 2 | 1 | - | - | 0 - No error detected 1 - Error raised due to current exceeds limits on HS
 | Communication error | 3 | 1 | - | - | 0 - No error detected 1 - Error detected due an communication error, bad field on received message, CRC, unknown message id…
 | Temperature | 4 | 1 | - | - | 0 - No error detected 1 - Temperature exceeds the security range.
 | Internal error | 5 | 1 | - | - | 0 - No error detected 1 - Internal error detected
 | Error value | 8 | 16 | - | - | Value of the last raised error
 | EPC Electrical Measures, Message ID: 0xYYC
 | Variable Name | Start bit | Bit length | Scaling | Type | Description
 | LS Voltage | 0 | 16 | mV | unsigned | Instantaneous EPC voltage on low side
 | LS Current | 16 | 16 | mA | signed | Instantaneous EPC current on low side
 | HS Voltage | 32 | 16 | mV | unsigned | Instantaneous EPC voltage on high side
 | EPC Temperature Measures, Message ID: 0xYYD
 | Variable Name | Start bit | Bit length | Scaling | Type | Description
 | Temp Body | 0 | 16 | mºC | signed | Temperatue on battery body
 | Temp Anode | 16 | 16 | mºC | signed | Temperatue on battery anode
 | Temp Ambient | 32 | 16 | mºC | signed | Temperatue on ambient

Sheet: HW_Vers
12 | 11 | 10 | 9 | 8 | 7 | 6 | 5 | 4 | 3 | 2 | 1 | 0
Reserved |  | Tamb | Tbody | Tanode_type |  | Connector |  |  | Vent | HW Rev
 |  | 0: No sensor | 0: No STS | 0: No anode 1: Ring 2: Plastic |  | 0: 18650 |  |  | 0: No vent | 0: Rev A
 |  | 1: Plastic NTC | 1: STS_SENS | 1: Ring NTC |  | 1: Banana |  |  | 1: Vent | 1: Reserved
 |  |  |  | 2: Plastic NTC |  | 2: Reserved |  |  |  | 2: Reserved
 |  |  |  | 3: Reserved |  | 3: Reserved |  |  |  | 3: Reserved
 |  |  |  |  |  | 4: Reserved |  |  |  | 4: Reserved
 |  |  |  |  |  | 5: Reserved |  |  |  | 5: Reserved
 |  |  |  |  |  | 6: Reserved |  |  |  | 6: Reserved
