WattRex/Regenerative-Battery-Cycler/(threads)

Thread 14 (2023-05-29):

SW Module HAL_I2C

pastorpflores, 2023-05-29:

RobertoAldea, 2023-06-02:
#5 @mariuscrsn Change the module name as it is too specific for the sensor use in the project. Also the interface has been change, the old interface has been replace just by a function to read the temperature from the sensor.
The new interface will be this:
```
HAL_STS_result_e HAL_StsInit(void);
HAL_STS_result_e HAL_StsReadTemperature(uint16_t* temp);
```

Thread 62 (2023-06-16):

Add functions for filters

mariuscrsn, 2023-06-16:
`HAL_CAN_result_e HAL_CanFilters(const uint16_t id, const uint16_t mask);` : https://github.com/WattRex/Regenerative-Battery-Cycler/blob/6d5da96e113f1579cba2b97511472f8bcc482c18/firmware/Sources/HAL/HAL_CAN/hal_can.h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 Should be
`HAL_CAN_result_e HAL_CanAddFilter(const uint16_t id, const uint16_t mask);`

RobertoAldea, 2023-06-19:
Added change and also added function to delete all filters

Thread 152 (2024-07-30):

Hardware: schematic, bom list, PCB gerber files

rexlee2, 2024-07-30:
This seems to be a great open-source project.
Has the hardware schematic, BOM, and PCB gerber files be shared yet?
