WattRex/Regenerative-Battery-Cycler/doc/electrical_cad.pdf

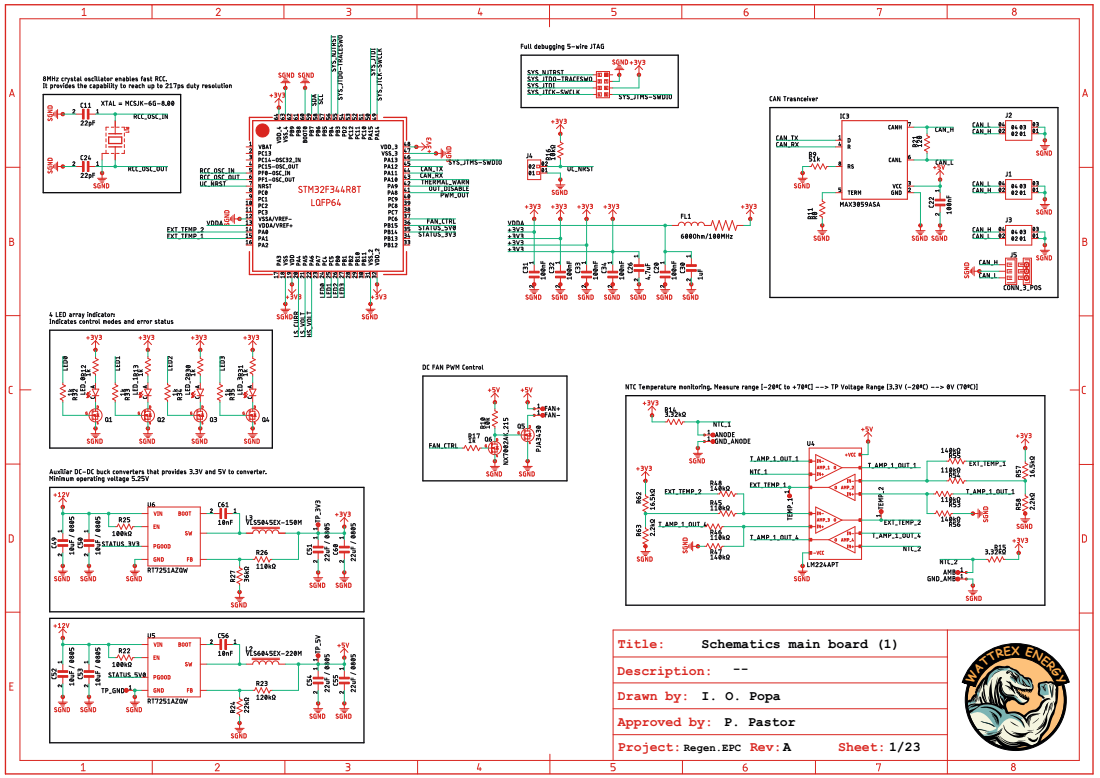
[picture p1: page 1]
Title:; Description:; Drawn by:; Approved by:; Project:; Rev:; Sheet:; TREX ENE T; I. O. Popa; P. Pastor; Regen.EPC

Schematics main board (1)

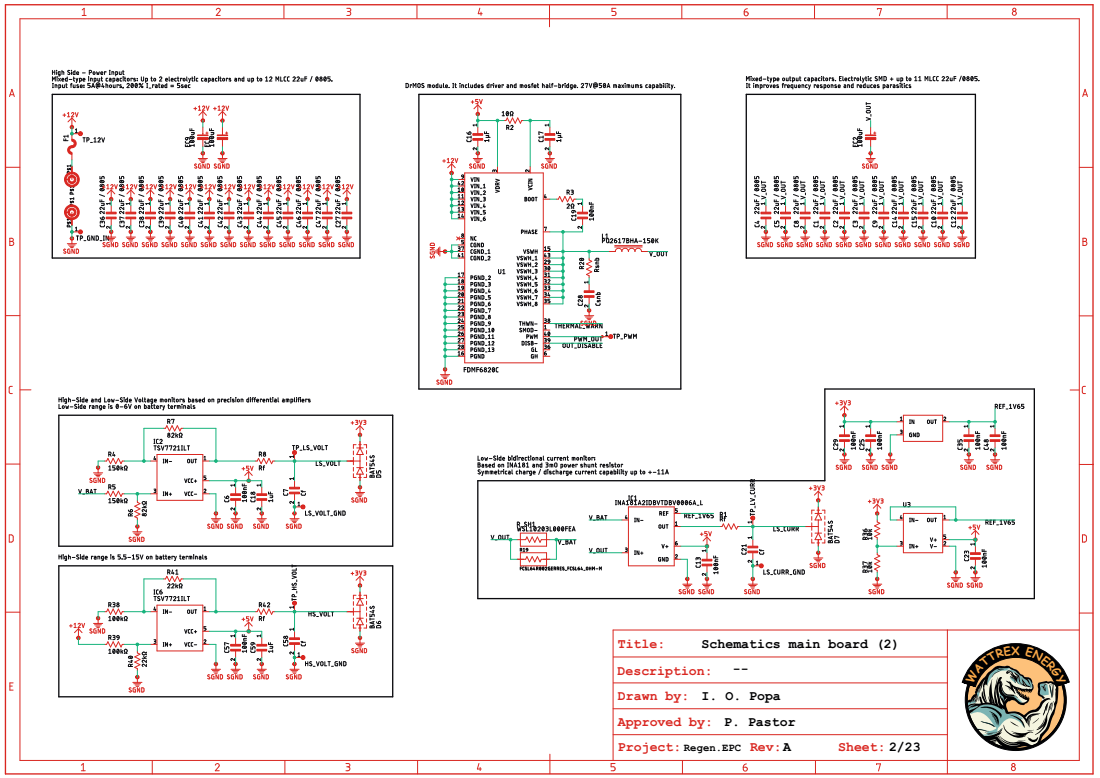
[picture p2: page 2]
Title:; Description:; Drawn by:; TREX ENE T; I. O. Popa; Regen.EPC

Schematics main board (2)

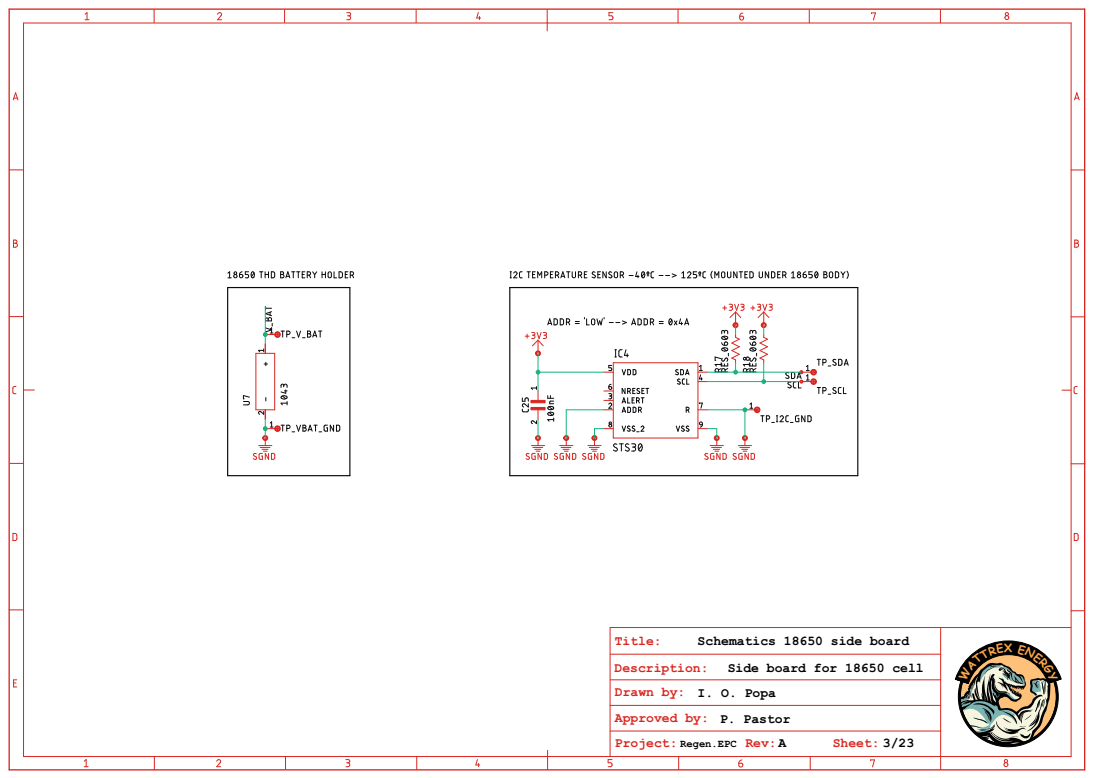
[picture p3: page 3]
Title:; Description:; Drawn by:; TREX ENE T R A GY W; TREX ENE T; I. O. Popa; Regen.EPC

Schematics 18650 side board

Side board for 18650 cell

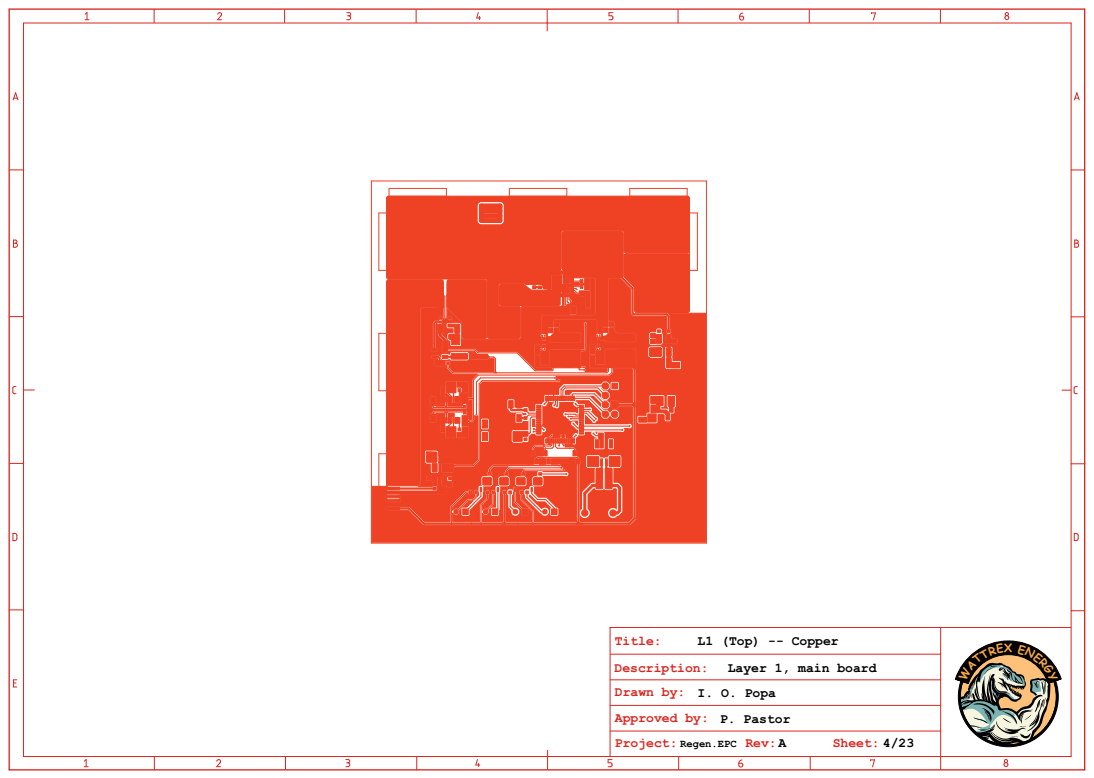
[picture p4: page 4]
Title:; Description:; Drawn by:; TREX ENE T R A GY W; TREX ENE T; L1 (Top) -- Copper; I. O. Popa; Regen.EPC

Layer 1, main board

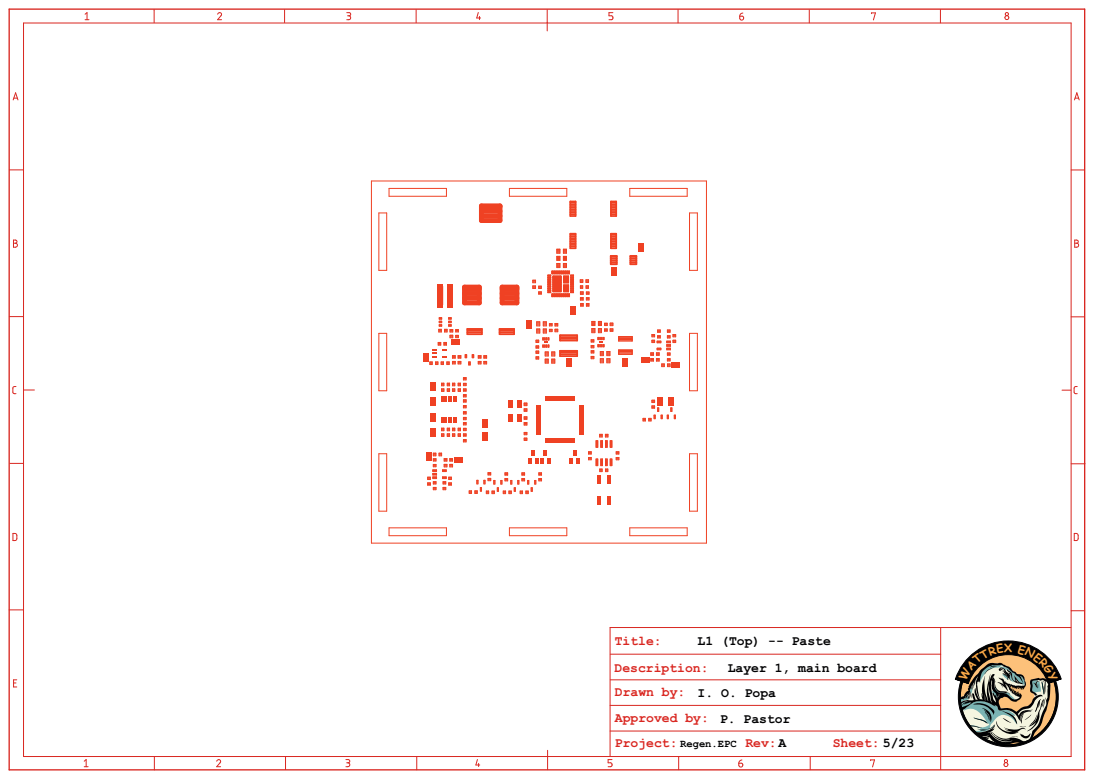
[picture p5: page 5]
Title:; Description:; Drawn by:; TREX ENE T; L1 (Top) -- Paste; I. O. Popa; Regen.EPC

Layer 1, main board

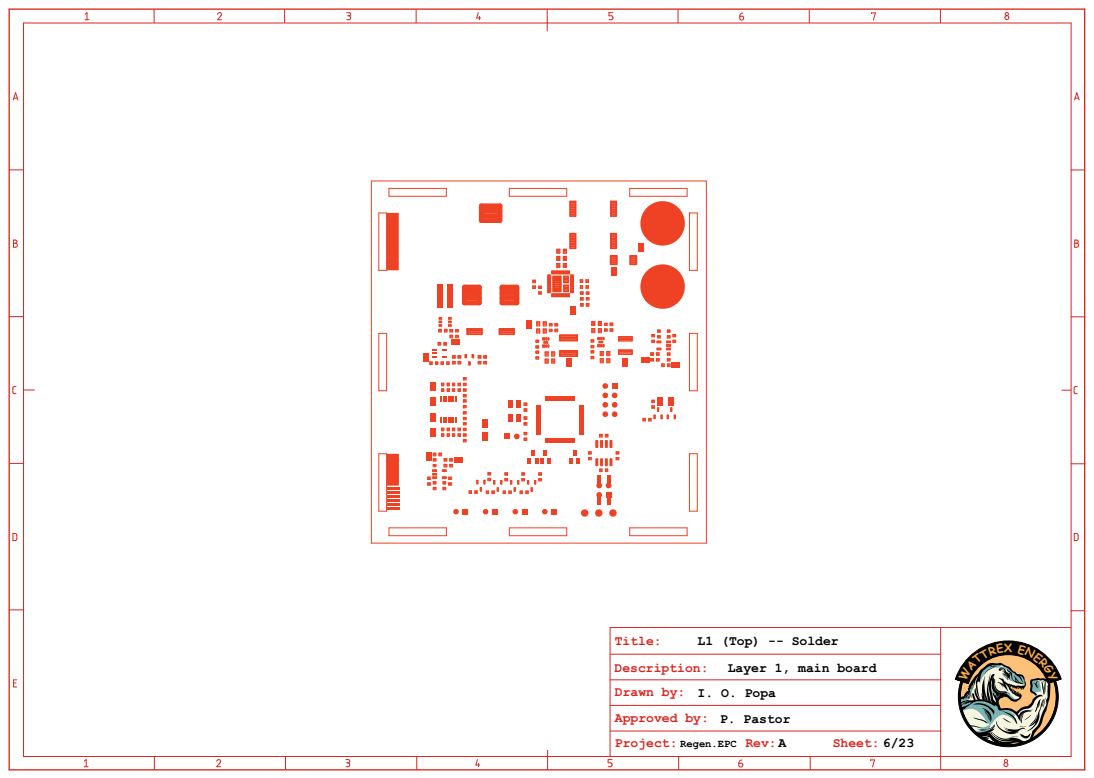
[picture p6: page 6]
Title:; Description:; Drawn by:; TREX ENE T; L1 (Top) -- Solder; I. O. Popa; Regen.EPC

Layer 1, main board

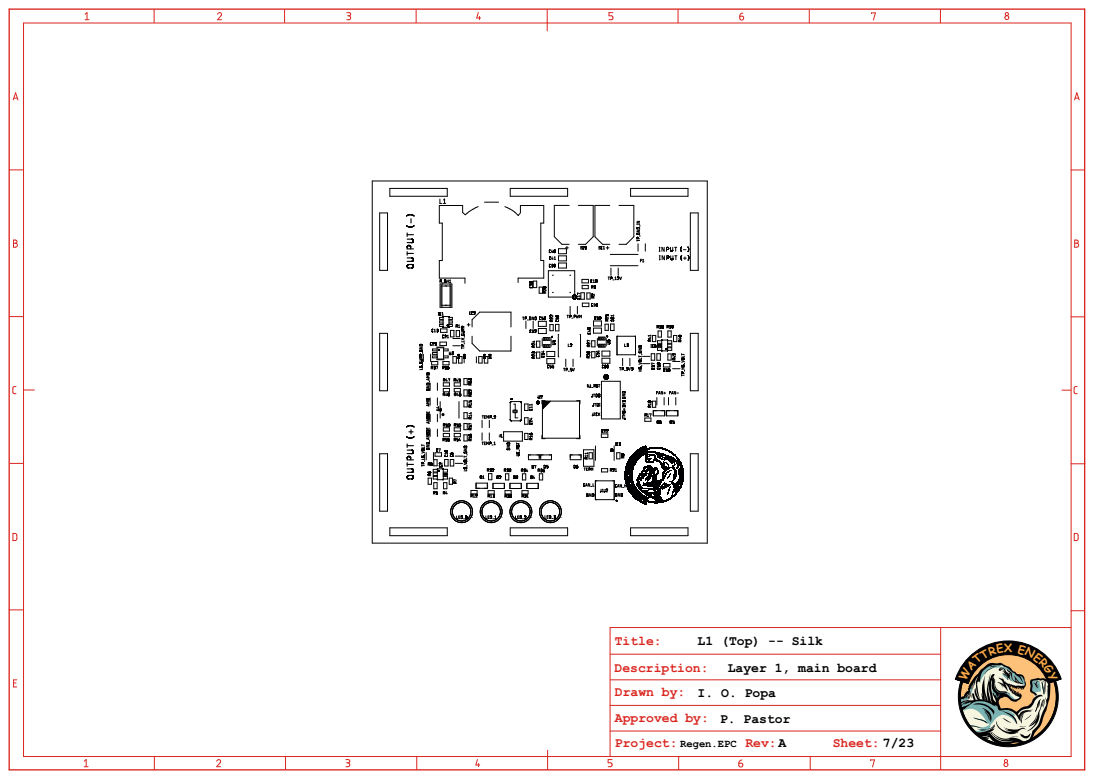
[picture p7: page 7]
Title:; Description:; Drawn by:; TREX ENE T; L1 (Top) -- Silk; I. O. Popa; Regen.EPC

Layer 1, main board

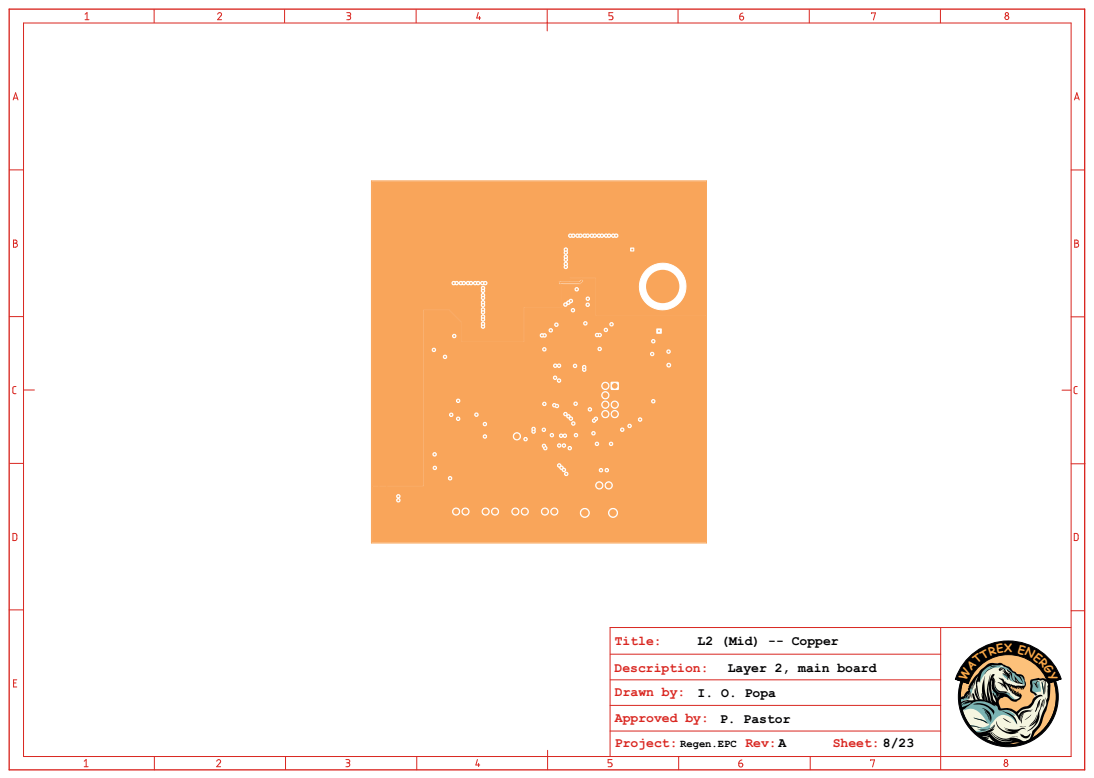
[picture p8: page 8]
Title:; Description:; Drawn by:; TREX ENE T; L2 (Mid) -- Copper; I. O. Popa; Regen.EPC

Layer 2, main board

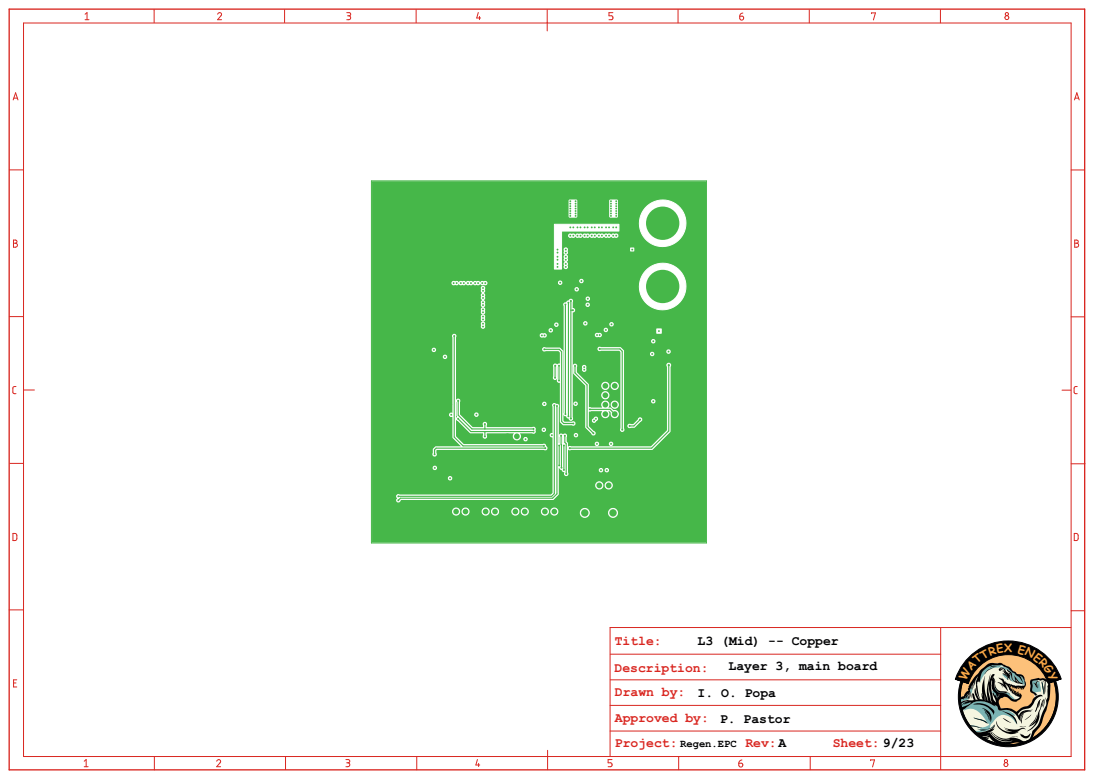
[picture p9: page 9]
Title:; Description:; Drawn by:; TREX ENE T; L3 (Mid) -- Copper; I. O. Popa; Regen.EPC

Layer 3, main board

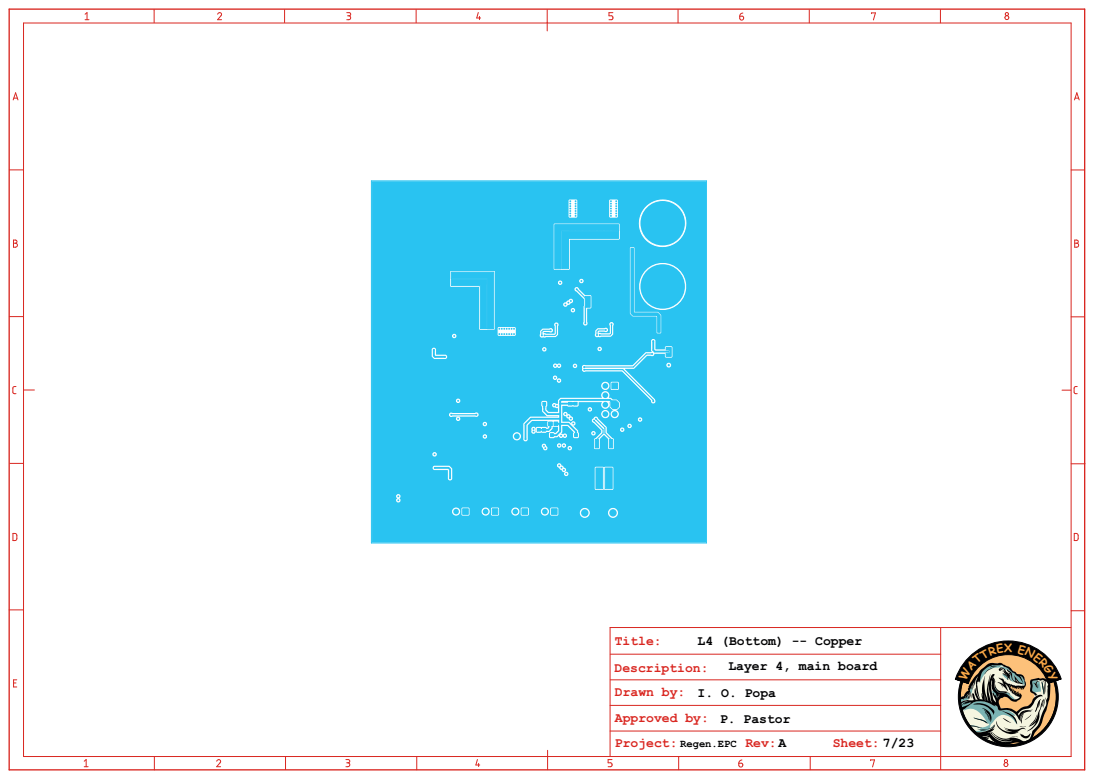
[picture p10: page 10]
Title:; Description:; Drawn by:; TREX ENE T; L4 (Bottom) -- Copper; I. O. Popa; Regen.EPC

Layer 4, main board

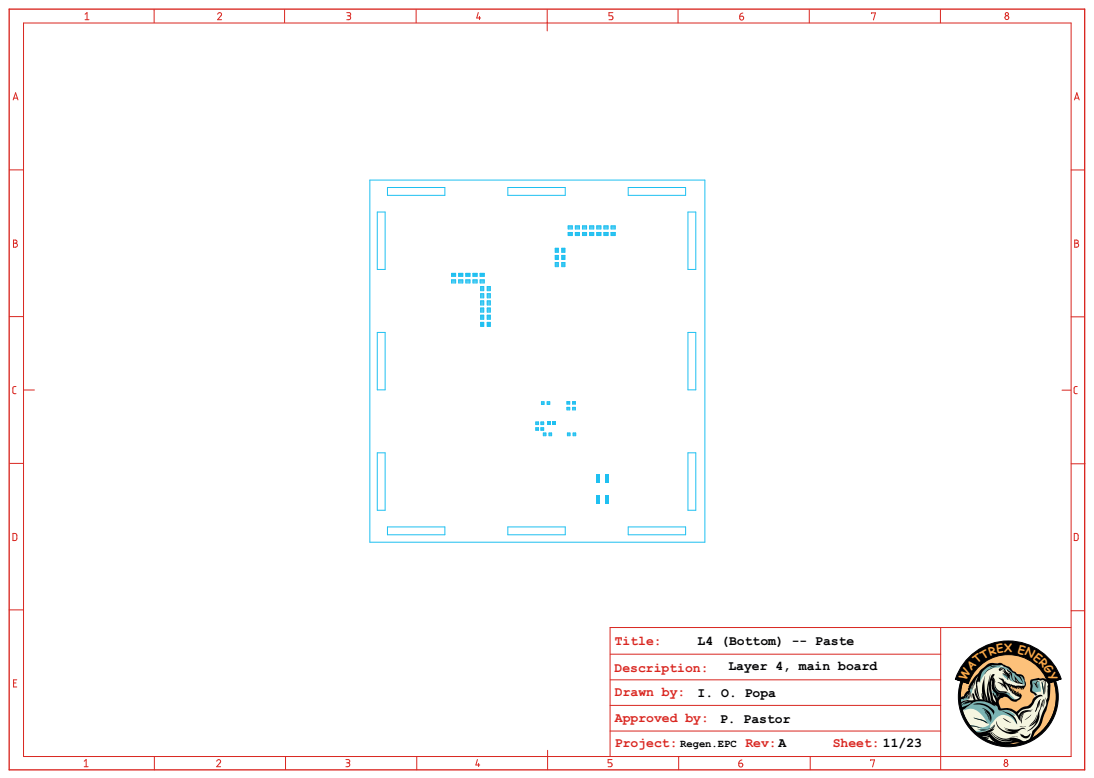
[picture p11: page 11]
Title:; Description:; Drawn by:; TREX ENE T; L4 (Bottom) -- Paste; I. O. Popa; Regen.EPC

Layer 4, main board

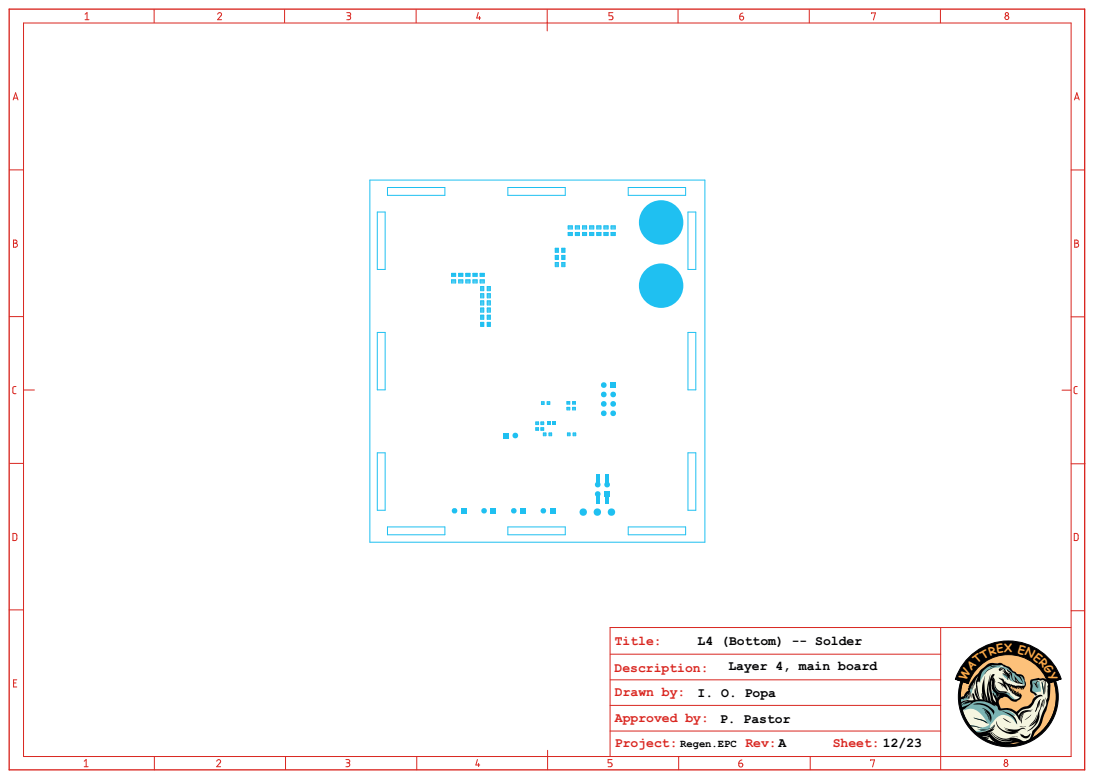
[picture p12: page 12]
Title:; Description:; Drawn by:; TREX ENE T; L4 (Bottom) -- Solder; I. O. Popa; Regen.EPC

Layer 4, main board

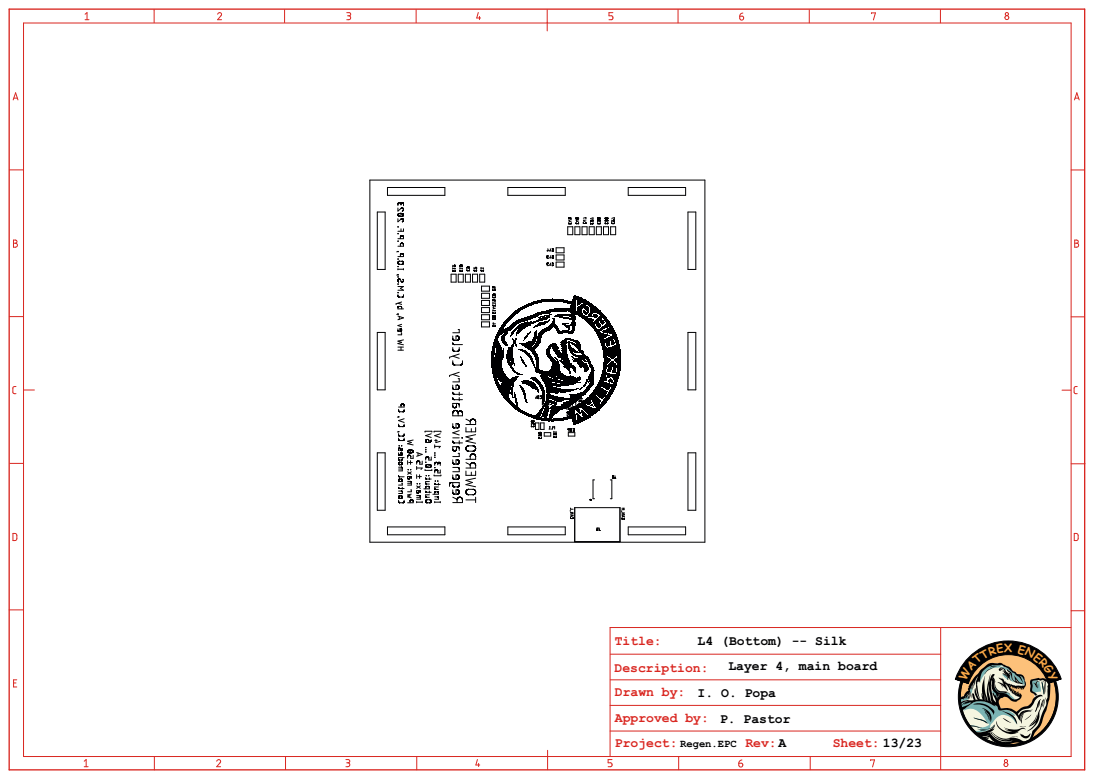
[picture p13: page 13]
Title:; Description:; Drawn by:; TREX ENE T; L4 (Bottom) -- Silk; I. O. Popa; Regen.EPC

Layer 4, main board

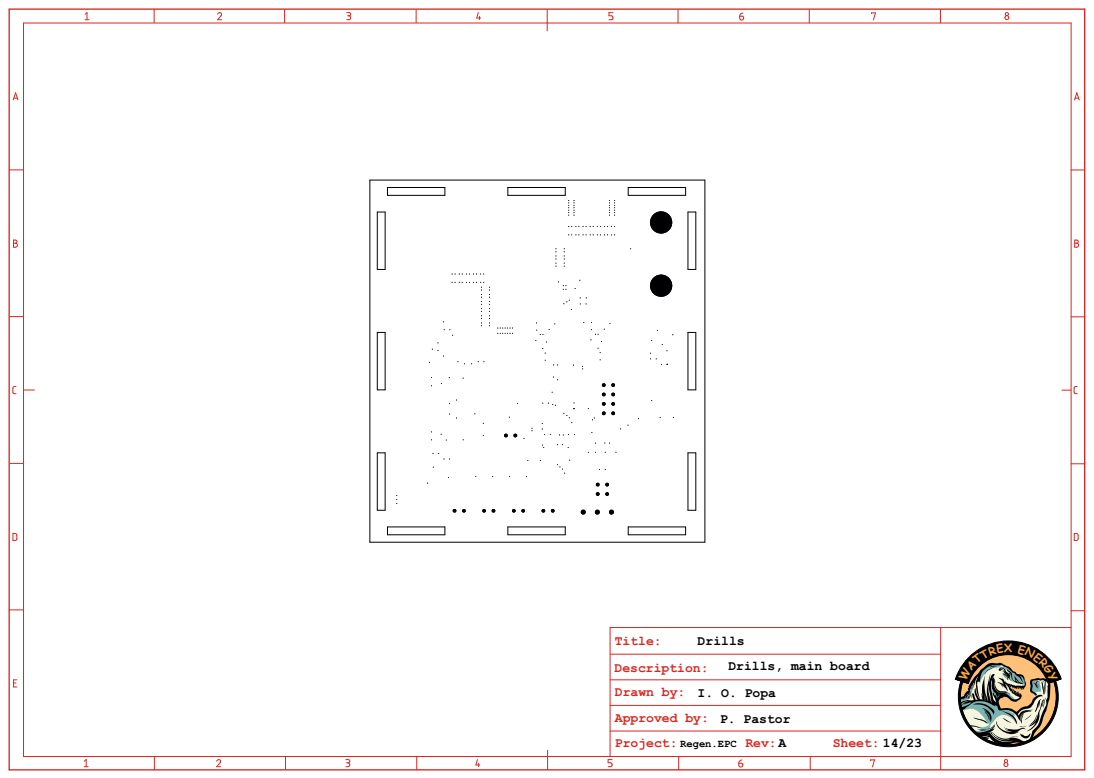
[picture p14: page 14]
Title:; Description:; Drawn by:; TREX ENE T; Drills; I. O. Popa; Regen.EPC

Drills, main board

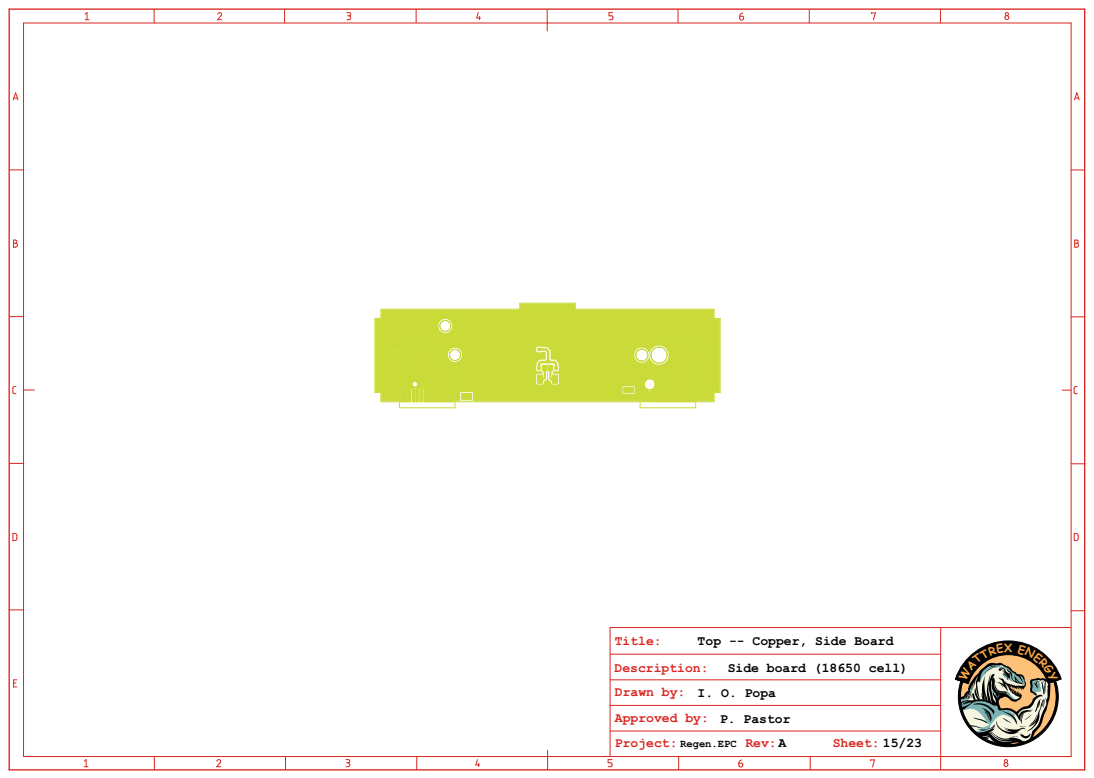
[picture p15: page 15]
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

Top -- Copper, Side Board

Side board (18650 cell)

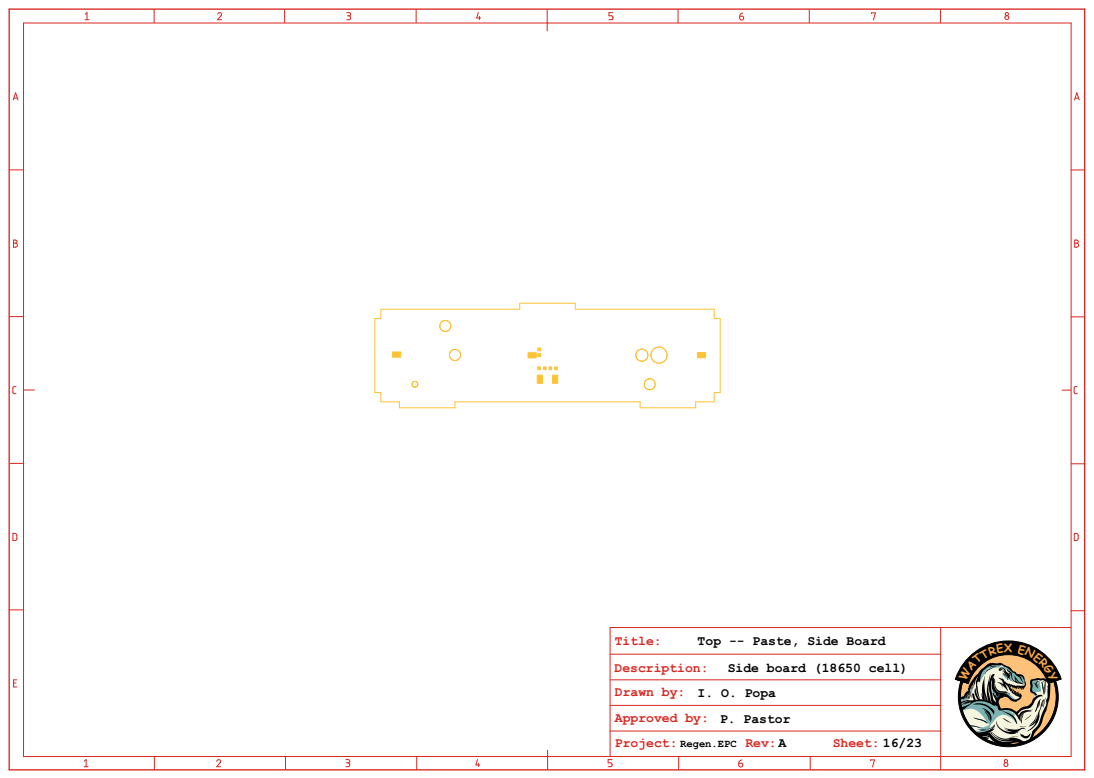
[picture p16: page 16]
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

Top -- Paste, Side Board

Side board (18650 cell)

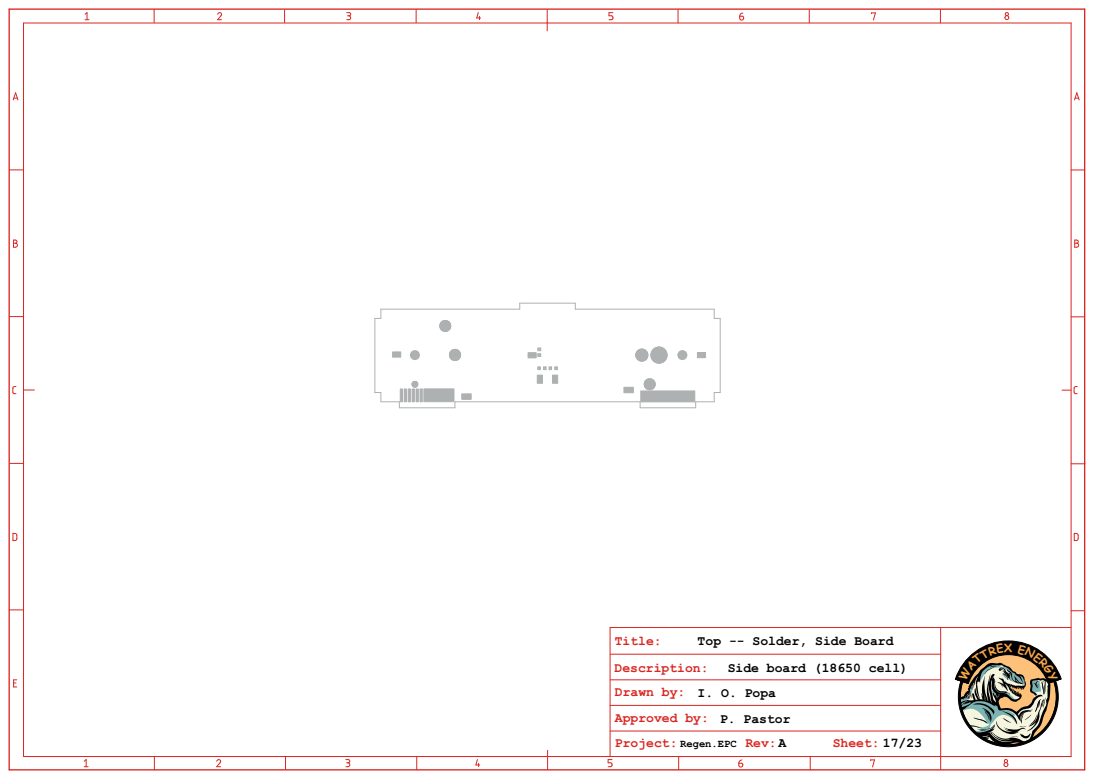
[picture p17: page 17]
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

Top -- Solder, Side Board

Side board (18650 cell)

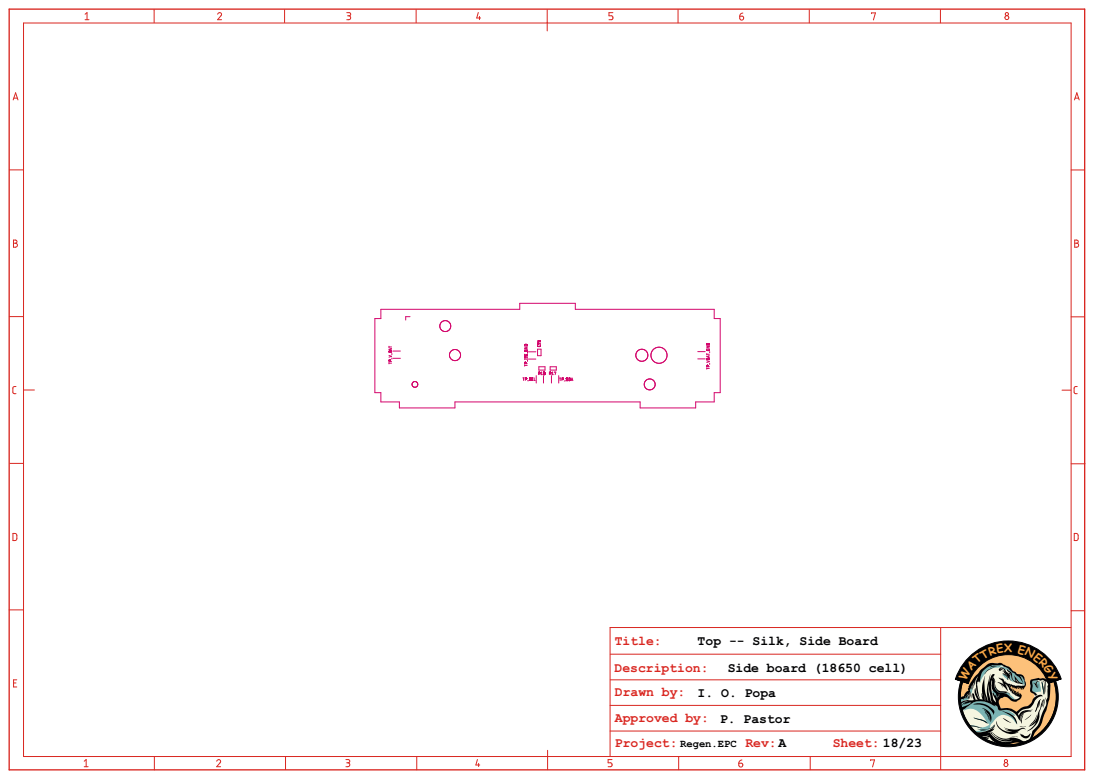
[picture p18: page 18]
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

Top -- Silk, Side Board

Side board (18650 cell)

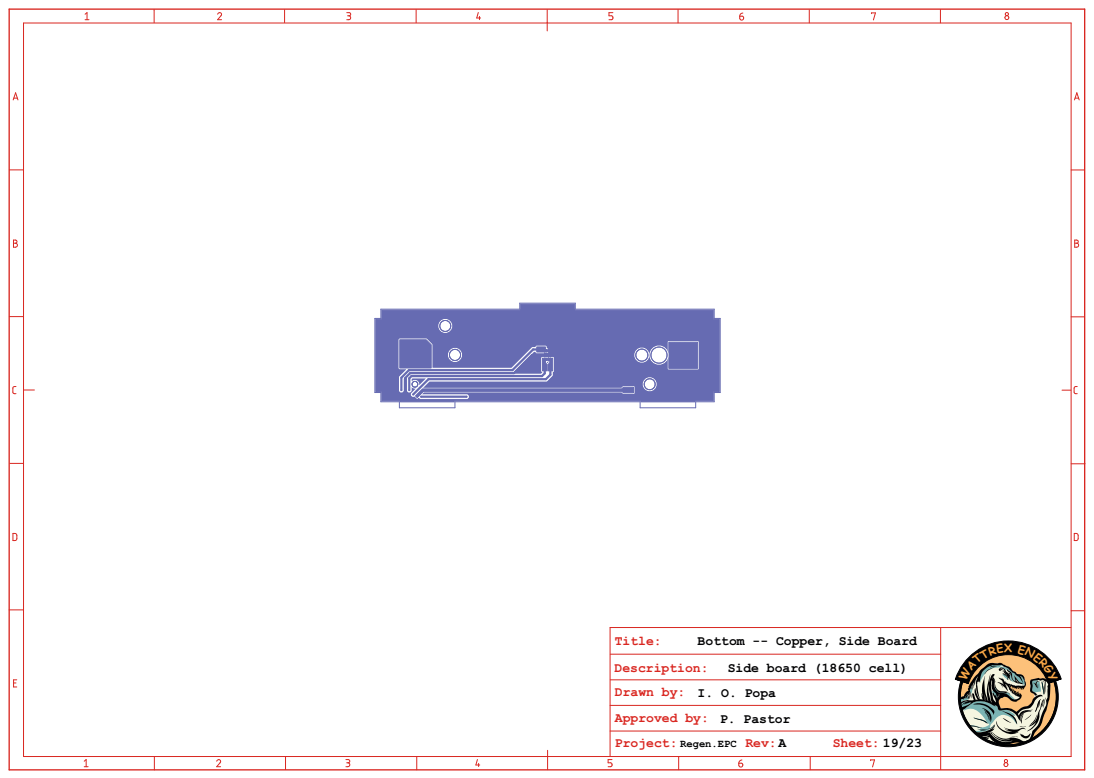
[picture p19: page 19]
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

Bottom -- Copper, Side Board

Side board (18650 cell)

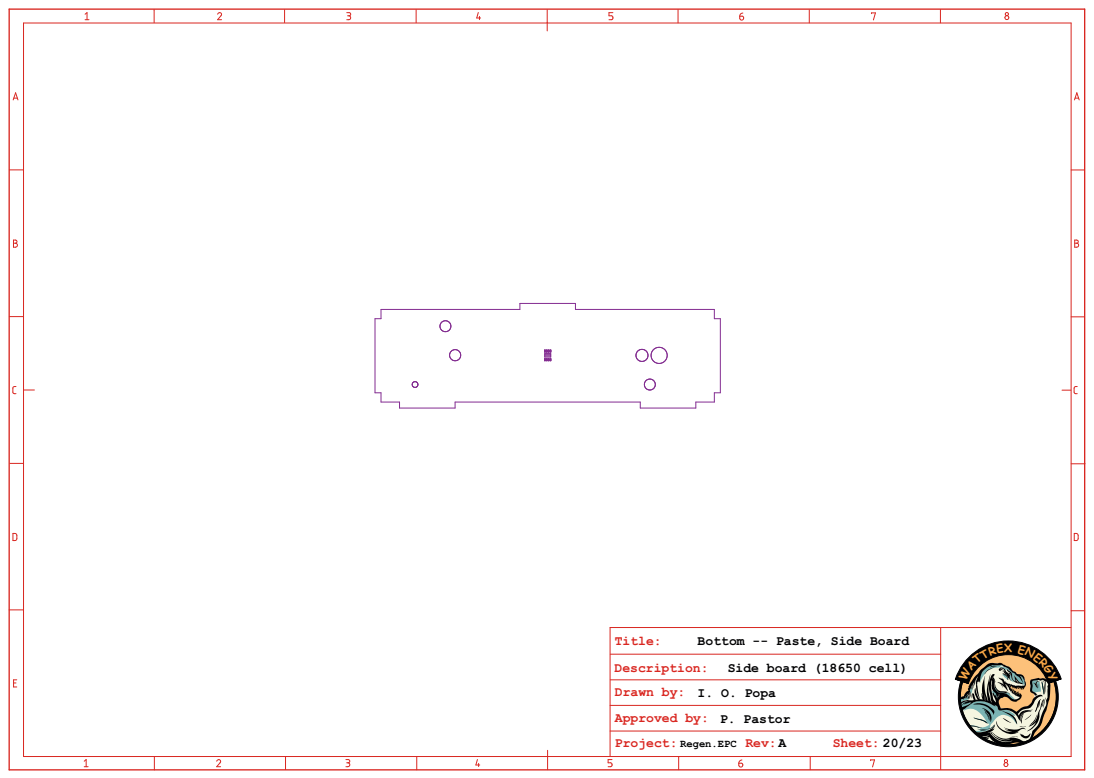
[picture p20: page 20]
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

Bottom -- Paste, Side Board

Side board (18650 cell)

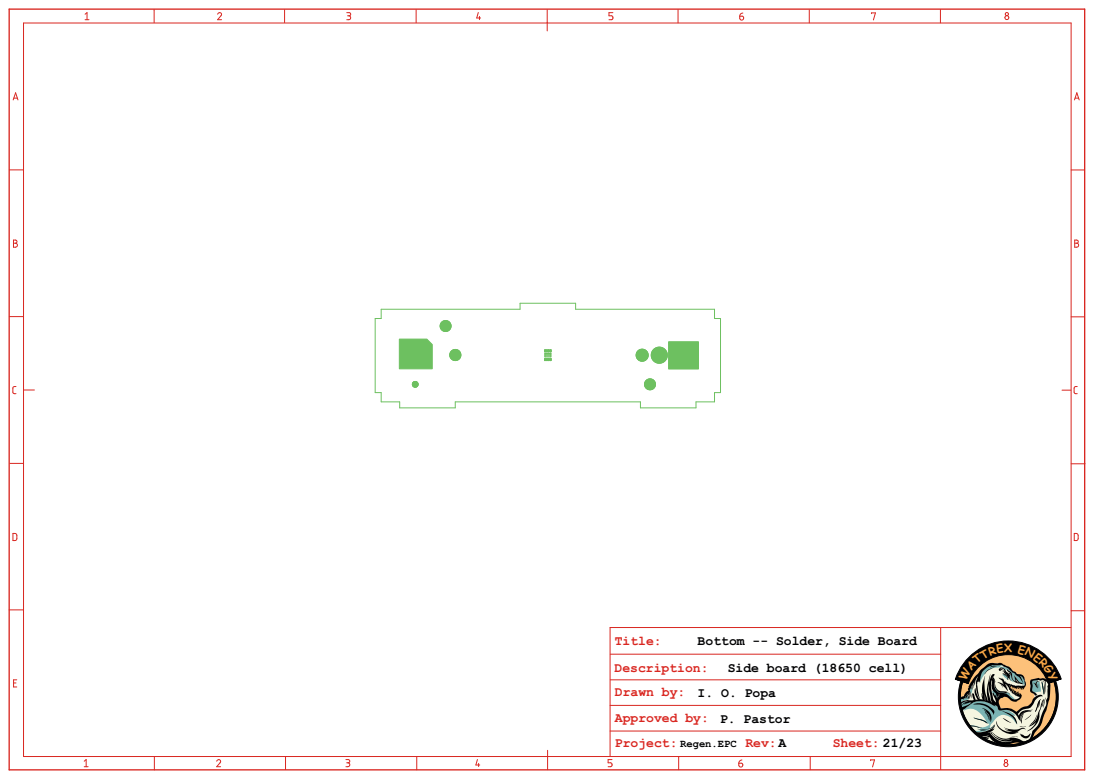
[picture p21: page 21]
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

Bottom -- Solder, Side Board

Side board (18650 cell)

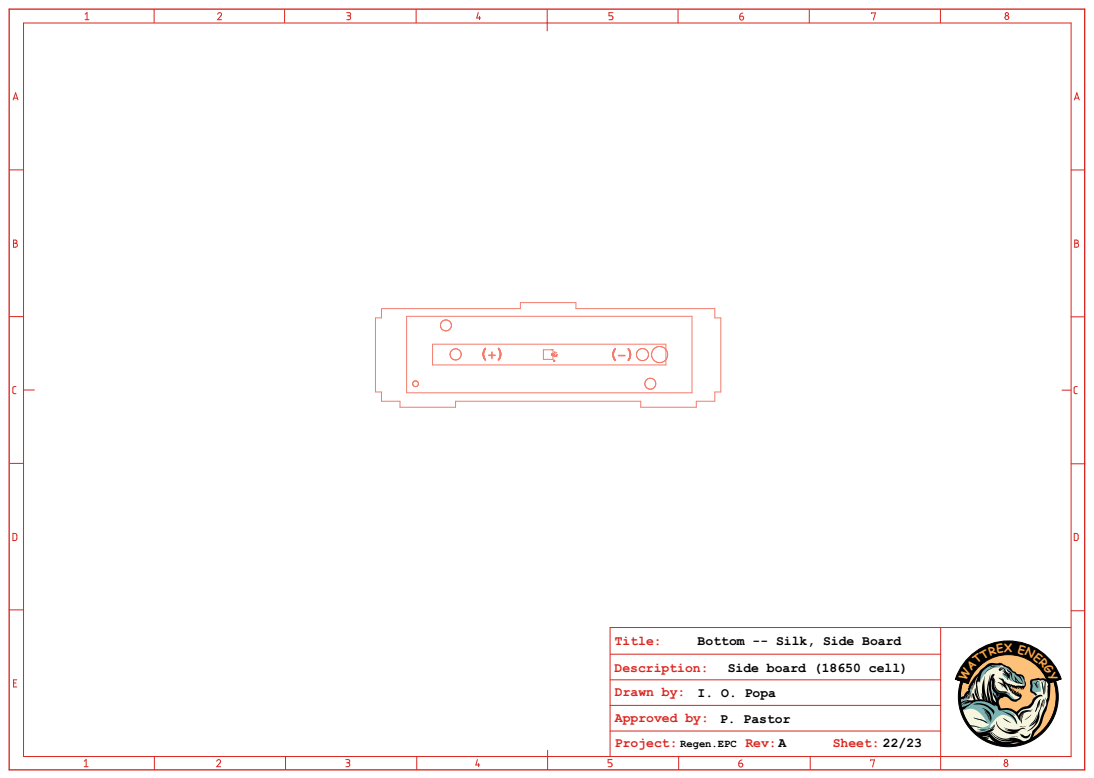
[picture p22: page 22]
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

Bottom -- Silk, Side Board

Side board (18650 cell)

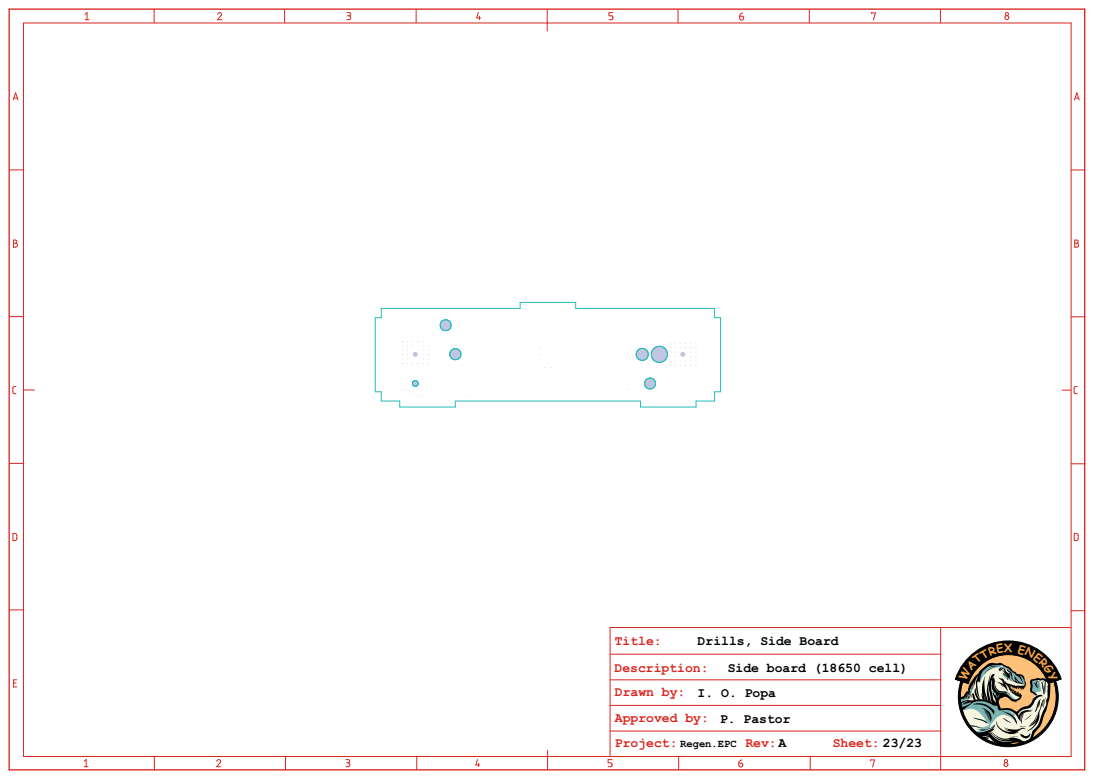
[picture p23: page 23]
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

Drills, Side Board

Side board (18650 cell)
