WattRex/Regenerative-Battery-Cycler/doc/EPC/EPC.brd

## EAGLE design doc/EPC/EPC.brd (2023-09-15)

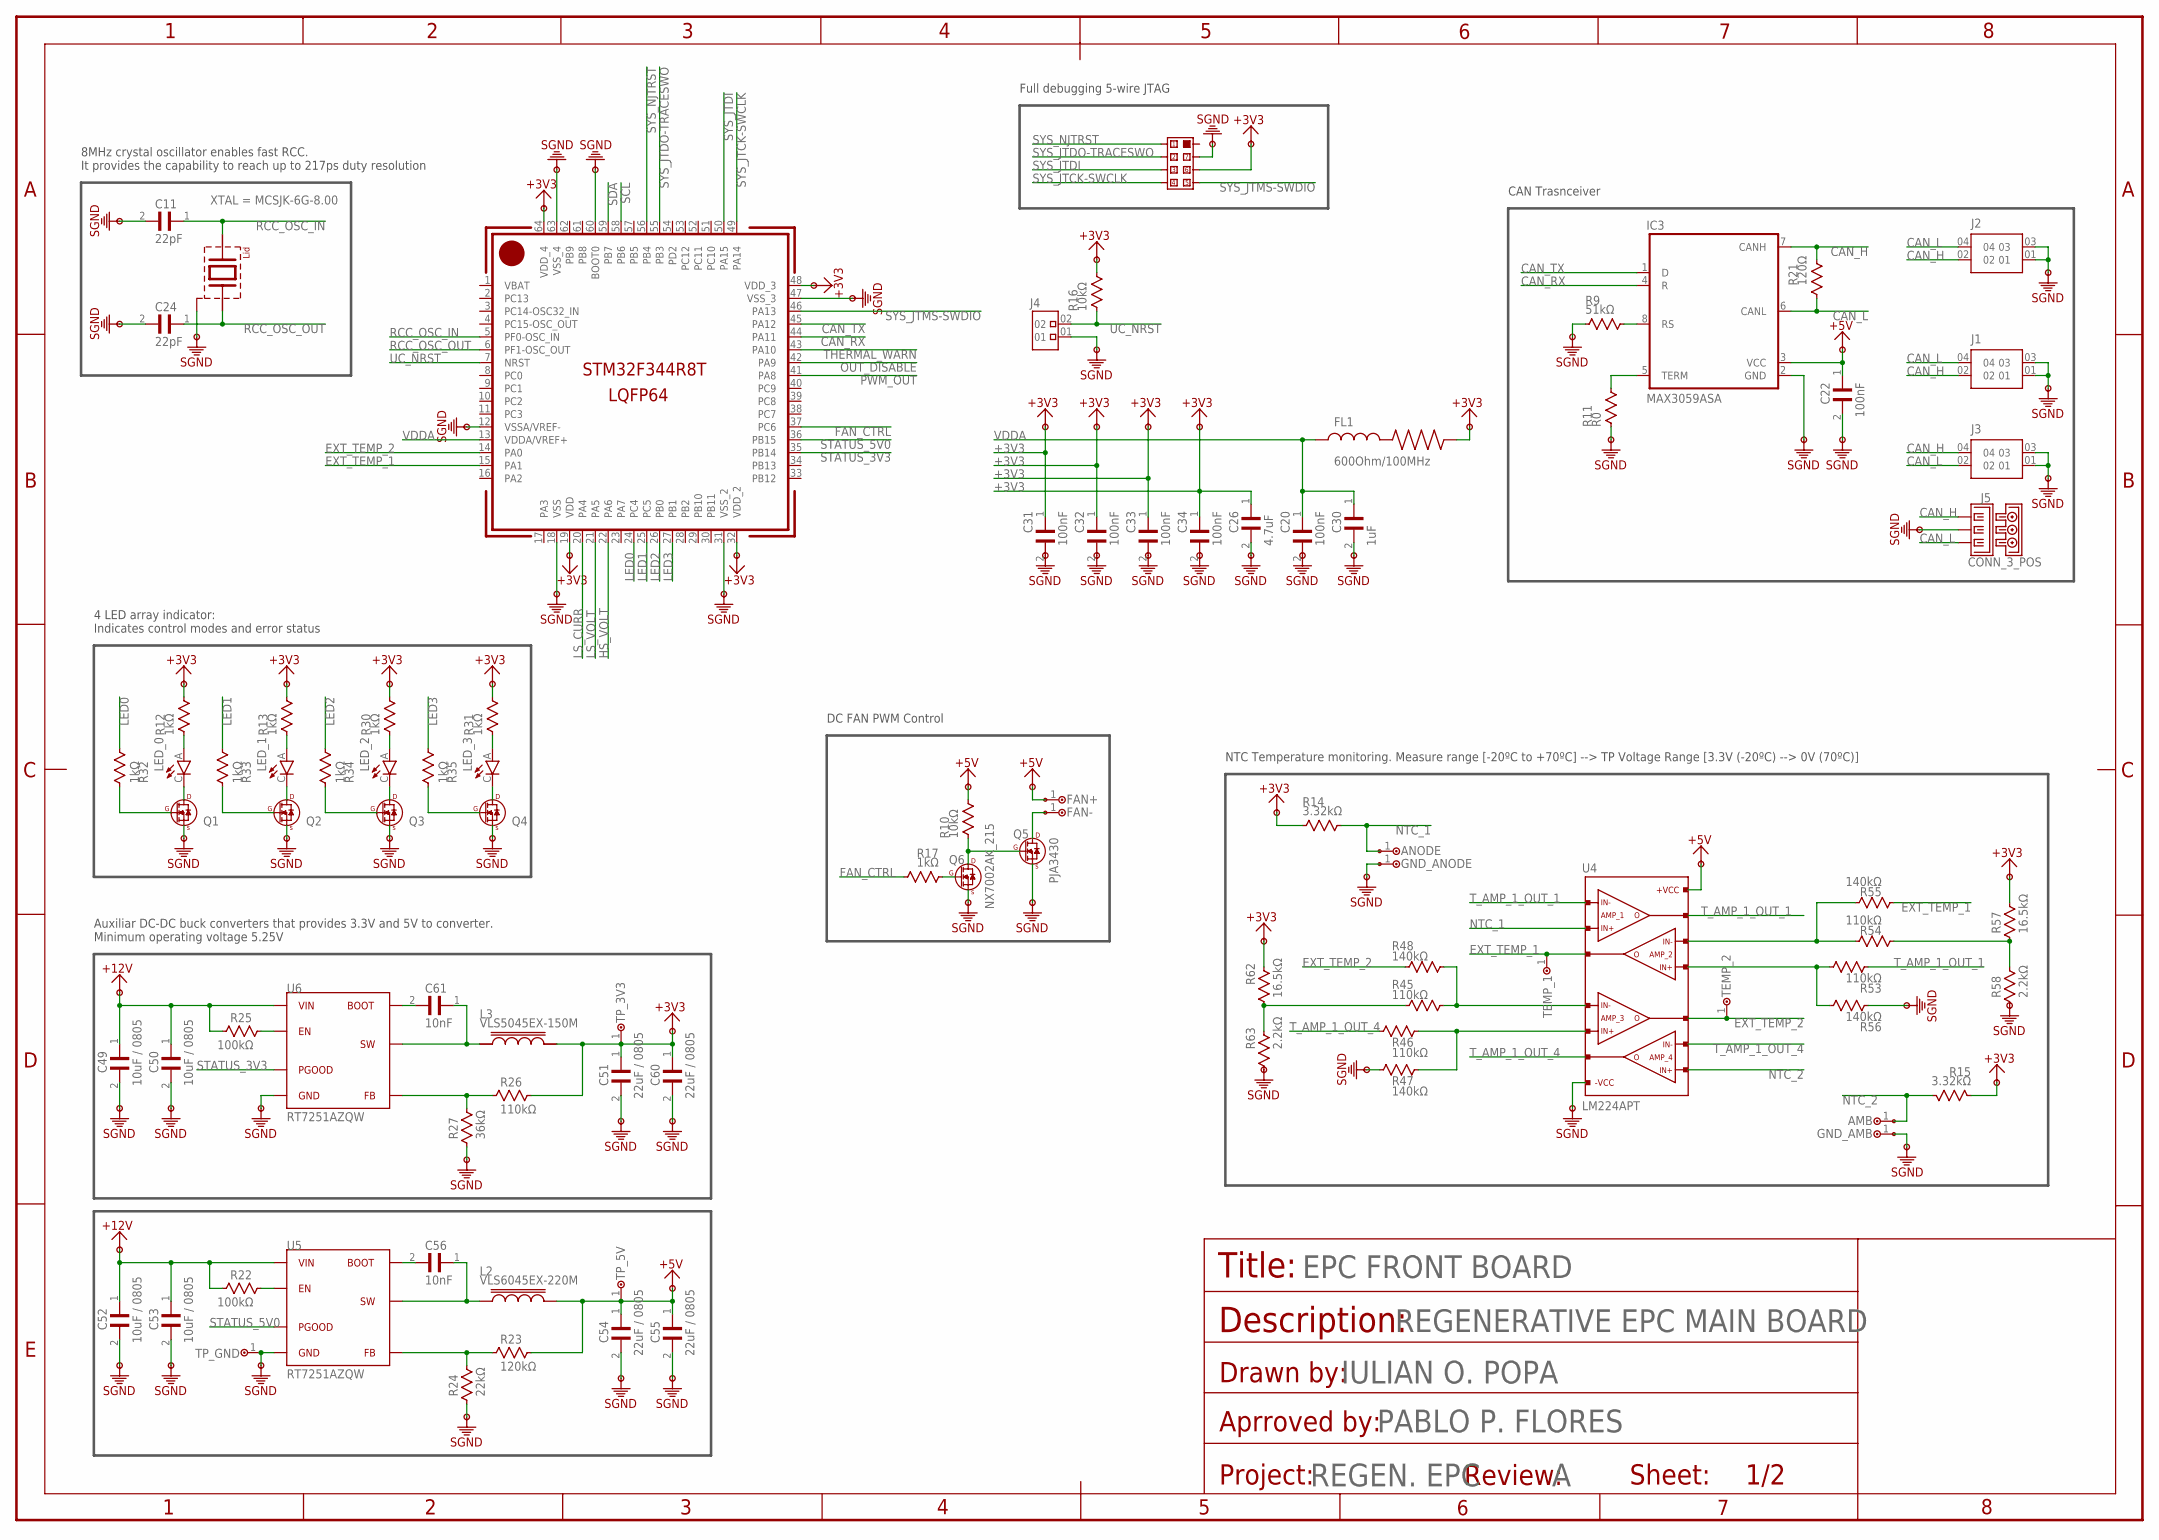
[picture p24: schematic EPC.sch, sheet 1]

Parts:
AMB: TP_S2751-46R
ANODE: TP_S2751-46R
C11, C24: 22pF; CAP_0603
C20, C22, C31, C32, C33, C34: 100nF; CAP_0603
C26: 4.7uF; CAP_0603
C30: 1uF; CAP_0603
C49, C50, C52, C53: 10uF / 0805; CAP_0805
C51, C54, C55, C60: 22uF / 0805; CAP_0805
C56, C61: 10nF; CAP_0603
FAN+: TP_S2751-46R
FAN-: TP_S2751-46R
FL1: 600Ohm/100MHz; FERR_0603_600OHM
GND_AMB: TP_S2751-46R
GND_ANODE: TP_S2751-46R
IC3: MAX3059ASA
J1, J3: SSM-102-T-DV
J2: TSW-125-19-T-D
J4: 2_POS_HEADER
J5: CONN_3_POS
JTAG1: JTAG
L2: VLS6045EX-220M; IND_VLS6045EX-220M
L3: VLS5045EX-150M; IND_VLS5045EX-150M
LED_0, LED_1, LED_2, LED_3: WP7113ID; LED_WP7113ID
Q1, Q2, Q3, Q4, Q6: NX7002AK_215
Q5: PJA3430; NX7002AK_215
R9: 51kΩ; RES_0603
R10, R16: 10kΩ; RES_0603
R11: R0; RES_0603
R12, R13, R17, R30, R31, R32, R33, R34, R35: 1kΩ; RES_0603
R14, R15: 3.32kΩ; RES_0603
R21: 120Ω; RES_0603
R22, R25: 100kΩ; RES_0603
R23: 120kΩ; RES_0603
R24: 22kΩ; RES_0603
R26, R45, R46, R53, R54: 110kΩ; RES_0603
R27: 36kΩ; RES_0603
R47, R48, R55, R56: 140kΩ; RES_0603
R57, R62: 16.5kΩ; RES_0603
R58, R63: 2.2kΩ; RES_0603
TEMP_1, TEMP_2: TP_S2751-46R
TP_3V3, TP_5V: TP_S2751-46R
TP_GND: TP_S2751-46R
U2: STM32F334R8T6; STM32F334R8
U4: LM224APT
U5, U6: RT7251AZQW; WDFN-8L
XTAL1: MCSJK-7I-8.00-10-30-60-B-30

Connections:
+3V3: C26.1, C31.1, C32.1, C33.1, C34.1, C51.1, C60.1, FL1.2, JTAG1.06 (6), L3.2, R12.2, R13.2, R14.1, R15.1, R16.2, R26.2, R30.2, R31.2, R57.2, R62.2, TP_3V3.1, U2.19 (VDD), U2.32 (VDD_2), U2.48 (VDD_3), U2.64 (VDD_4); also elsewhere on the board
+5V: C22.1, C54.1, C55.1, FAN+.1, IC3.3 (VCC), L2.2, R10.2, R23.2, TP_5V.1, U4.4 (VCC+); also elsewhere on the board
+12V: C49.1, C50.1, C52.1, C53.1, R22.1, R25.1, U5.2 (VIN), U6.2 (VIN); also elsewhere on the board
CAN_H: IC3.7 (CANH), J1.02, J2.02, J3.04, J5.1, R21.2
CAN_L: IC3.6 (CANL), J1.04, J2.04, J3.02, J5.3, R21.1
CAN_RX: IC3.4 (R), U2.44 (PA11)
CAN_TX: IC3.1 (D), U2.45 (PA12)
EXT_TEMP_1: R55.1, TEMP_1.1, U2.15 (PA1), U4.7 (OUTPUT_2)
EXT_TEMP_2: R48.2, TEMP_2.1, U2.14 (PA0), U4.8 (OUTPUT_3)
FAN_CTRL: R17.1, U2.37 (PC6)
HS_VOLT: U2.22 (PA6); also elsewhere on the board
LED0: R32.1, U2.24 (PC4)
LED1: R33.1, U2.25 (PC5)
LED2: R34.1, U2.26 (PB0)
LED3: R35.1, U2.27 (PB1)
LS_CURR: U2.20 (PA4); also elsewhere on the board
LS_VOLT: U2.21 (PA5); also elsewhere on the board
unnamed: Q5.1 (G), Q6.3 (D), R10.1
unnamed: FAN-.1, Q5.3 (D)
unnamed: Q6.1 (G), R17.2
unnamed: R25.2, U6.4 (EN)
unnamed: C61.1, L3.1, U6.1 (SW)
unnamed: R26.1, R27.2, U6.5 (FB)
unnamed: C61.2, U6.3 (BOOT)
unnamed: R22.2, U5.4 (EN)
unnamed: C56.1, L2.1, U5.1 (SW)
unnamed: R23.1, R24.2, U5.5 (FB)
unnamed: C56.2, U5.3 (BOOT)
unnamed: R45.1, R48.1, U4.9 (INVERTING_INPUT3)
unnamed: IC3.8 (RS), R9.2
unnamed: IC3.5 (TERM), R11.2
unnamed: LED_0.A, R12.1
unnamed: LED_0.C, Q1.3 (D)
unnamed: LED_1.C, Q2.3 (D)
unnamed: LED_1.A, R13.1
unnamed: LED_2.A, R30.1
unnamed: LED_2.C, Q3.3 (D)
unnamed: LED_3.C, Q4.3 (D)
unnamed: LED_3.A, R31.1
unnamed: Q1.1 (G), R32.2
unnamed: R46.2, R47.2, U4.10 (NON_INVERTING_INPUT_3)
unnamed: Q2.1 (G), R33.2
unnamed: Q3.1 (G), R34.2
unnamed: Q4.1 (G), R35.2
unnamed: R53.1, R56.1, U4.5 (NON_INVERTING_INPUT_2)
unnamed: R54.2, R55.2, U4.6 (INVERTING_INPUT2)
unnamed: R54.1, R57.1, R58.2
unnamed: R45.2, R62.1, R63.2
NTC_1: ANODE.1, R14.2, U4.3 (NON_INVERTING_INPUT_1)
NTC_2: AMB.1, R15.2, U4.12 (NON_INVERTING_INPUT_4)
OUT_DISABLE: U2.42 (PA9); also elsewhere on the board
PWM_OUT: U2.41 (PA8); also elsewhere on the board
RCC_OSC_IN: C11.1, U2.5 (PF0-OSC_IN), XTAL1.#1 (IN)
RCC_OSC_OUT: C24.1, U2.6 (PF1-OSC_OUT), XTAL1.#3 (OUT)
SCL: U2.58 (PB6)
SDA: U2.59 (PB7)
SGND: C11.2, C20.2, C22.2, C24.2, C26.2, C30.2, C31.2, C32.2, C33.2, C34.2, C49.2, C50.2, C51.2, C52.2, C53.2, C54.2, C55.2, C60.2, GND_AMB.1, GND_ANODE.1, IC3.2 (GND), J1.01, J1.03, J2.01, J2.03, J3.01, J3.03, J4.01, J5.2, JTAG1.07 (7), Q1.2 (S), Q2.2 (S), Q3.2 (S), Q4.2 (S), Q5.2 (S), Q6.2 (S), R9.1, R11.1, R24.1, R27.1, R47.1, R56.2, R58.1, R63.1, TP_GND.1, U2.12 (VSSA/VREF-), U2.18 (VSS), U2.31 (VSS_2), U2.47 (VSS_3), U2.60 (BOOT0), U2.63 (VSS_4), U4.11 (VCC-), U5.7 (GND), U5.8 (GND), U5.9 (GND), U6.7 (GND), U6.8 (GND), U6.9 (GND), XTAL1.GND (LID), XTAL1.GND_2 (LID); also elsewhere on the board
STATUS_3V3: U2.35 (PB14), U6.6 (PGOOD)
STATUS_5V0: U2.36 (PB15), U5.6 (PGOOD)
SYS_JTCK-SWCLK: JTAG1.04 (4), U2.49 (PA14)
SYS_JTDI: JTAG1.03 (3), U2.50 (PA15)
SYS_JTDO-TRACESWO: JTAG1.02 (2), U2.55 (PB3)
SYS_JTMS-SWDIO: JTAG1.05 (5), U2.46 (PA13)
SYS_NJTRST: JTAG1.01 (1), U2.56 (PB4)
THERMAL_WARN: U2.43 (PA10); also elsewhere on the board
T_AMP_1_OUT_1: R53.2, U4.1 (OUTPUT_1), U4.2 (INVERTING_INPUT1)
T_AMP_1_OUT_4: R46.1, U4.13 (INVERTING_INPUT4), U4.14 (OUTPUT_4)
UC_NRST: J4.02, R16.1, U2.7 (NRST)
VBAT: U2.1 (VBAT)
VDDA: C20.1, C30.1, FL1.1, U2.13 (VDDA/VREF+)

Notes on the sheet:
8MHz crystal oscillator enables fast RCC. It provides the capability to reach up to 217ps duty resolution
4 LED array indicator: Indicates control modes and error status
Auxiliar DC-DC buck converters that provides 3.3V and 5V to converter. Minimum operating voltage 5.25V
Full debugging 5-wire JTAG
CAN Trasnceiver
NTC Temperature monitoring. Measure range [-20ºC to +70ºC] --> TP Voltage Range [3.3V (-20ºC) --> 0V (70ºC)]
EPC FRONT BOARD
REGENERATIVE EPC MAIN BOARD
IULIAN O. POPA
PABLO P. FLORES
REGEN. EPC
DC FAN PWM Control

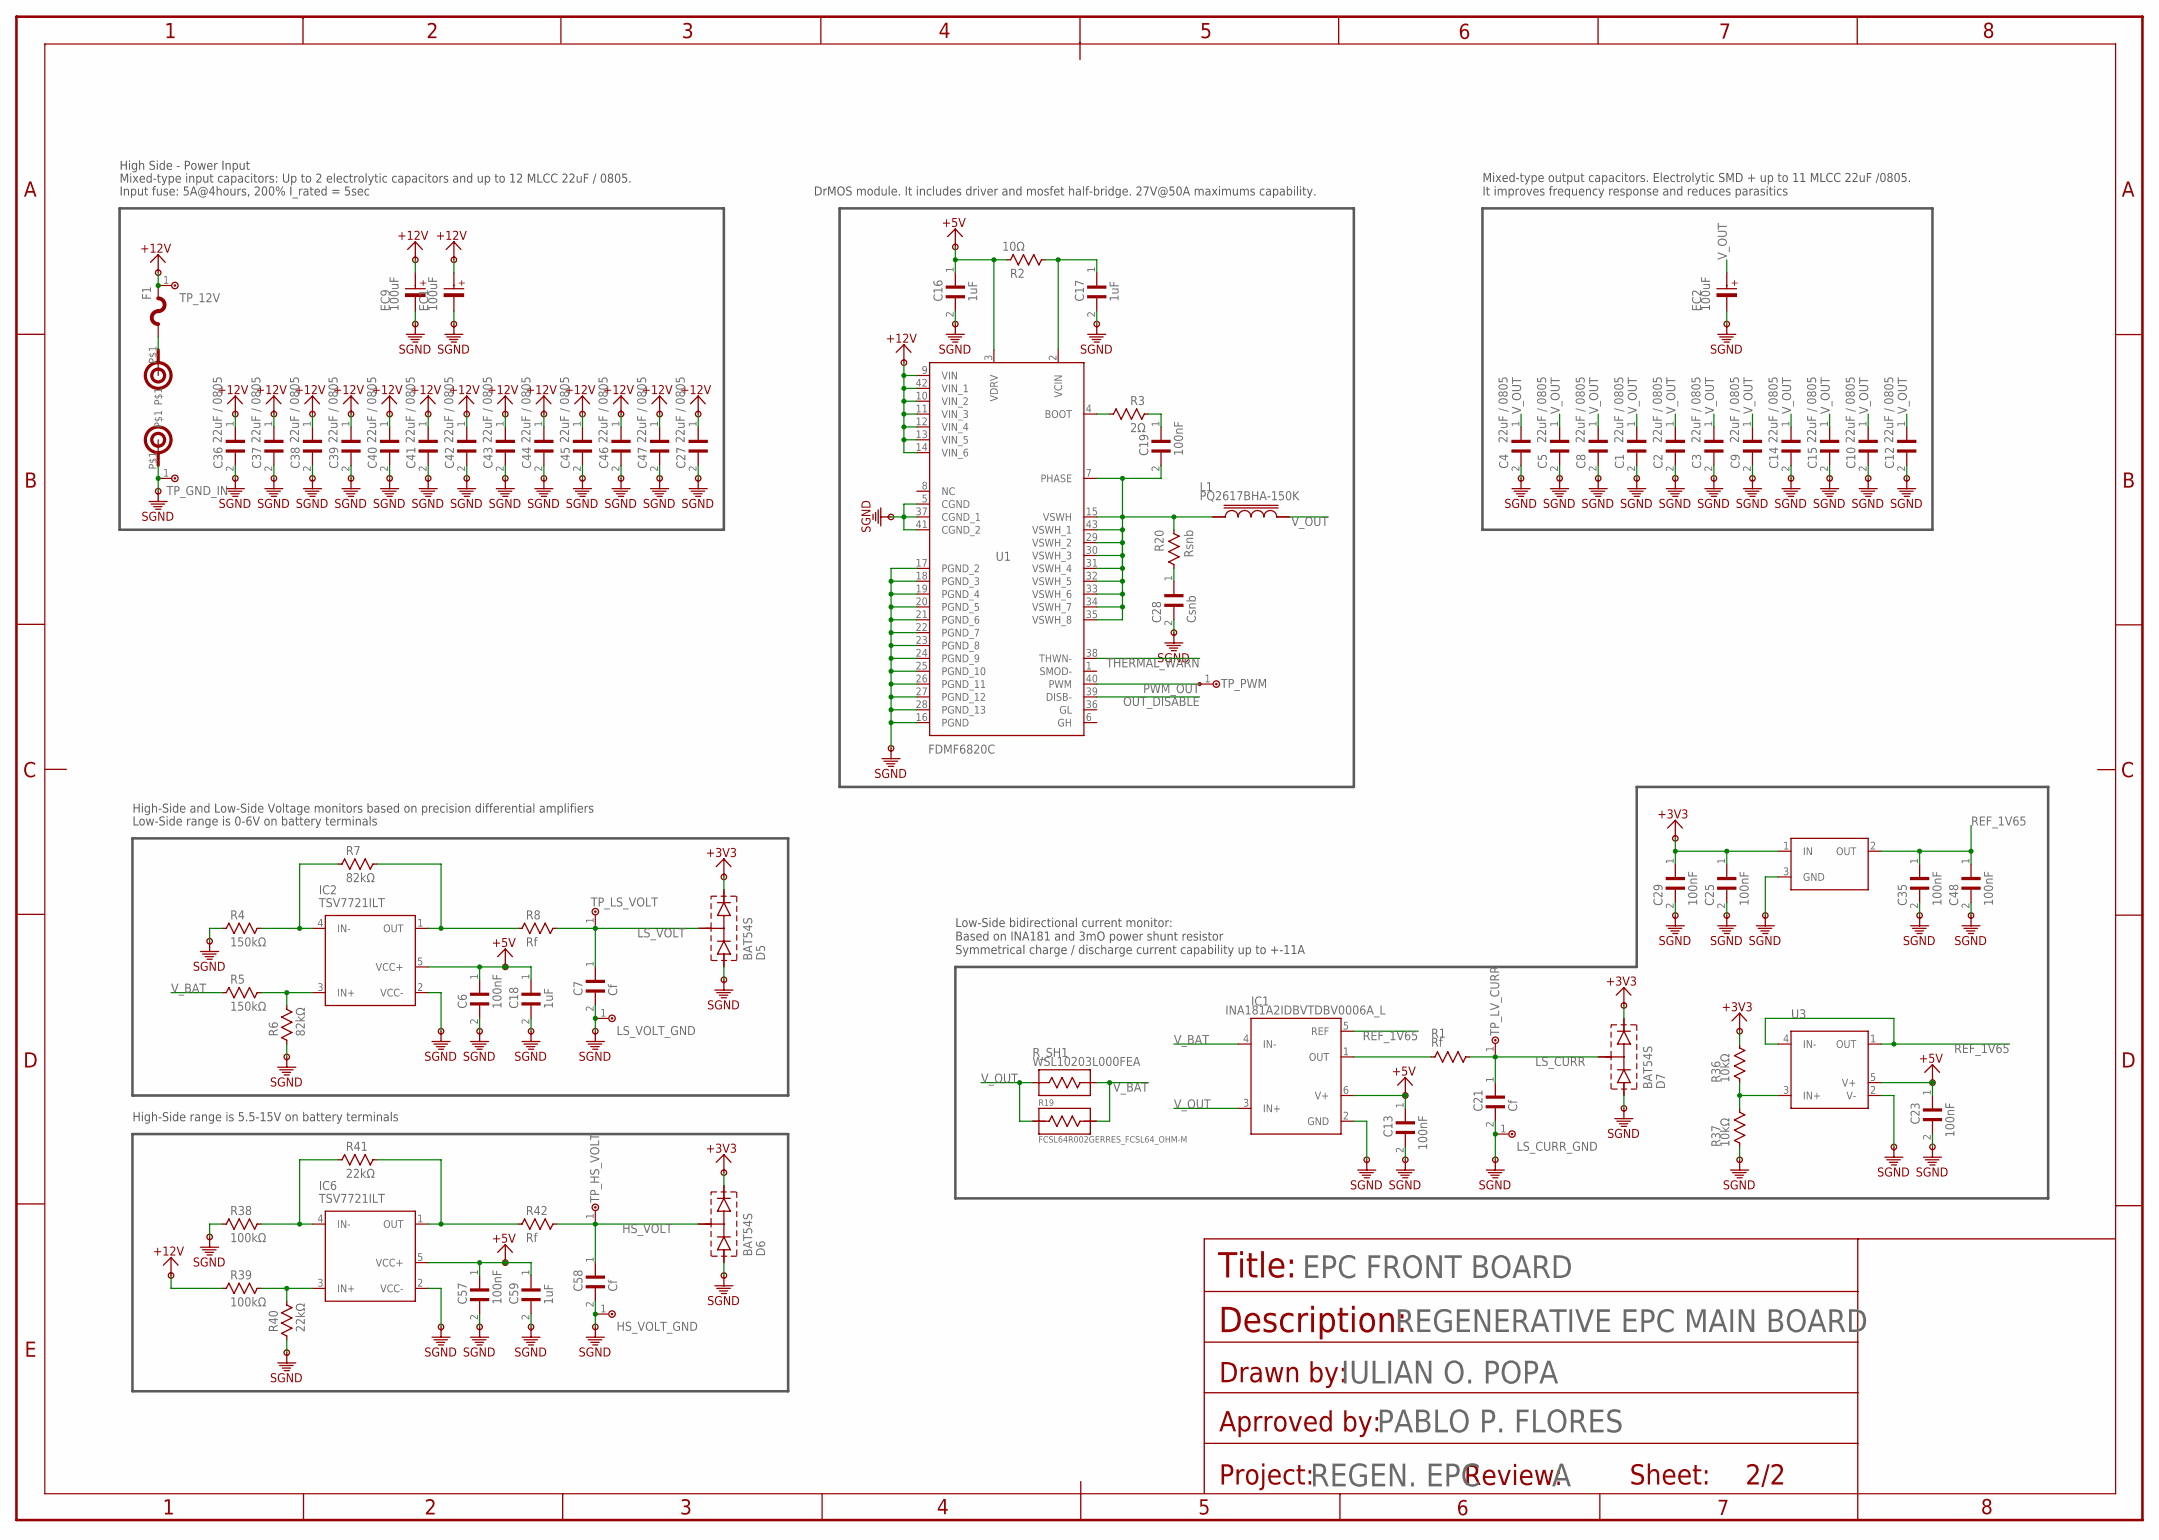
[picture p25: schematic EPC.sch, sheet 2]

Parts:
C1, C2, C3, C4, C5, C8, C9, C10, C12, C14, C15, C27, C36, C37, C38, C39, C40, C41, C42, C43, C44, C45, C46, C47: 22uF / 0805; CAP_0805
C6, C13, C19, C23, C25, C29, C35, C48, C57: 100nF; CAP_0603
C7, C21, C58: Cf; CAP_0603
C16, C17, C18, C59: 1uF; CAP_0603
C28: Csnb; CAP_0603
D5, D6, D7: BAT54S
EC1, EC2, EC9: 100uF; WCAP-PSLC_10X12.4(DXL)
F1: FUSE_SF-2410FP010T-2FUSE_SF_6P1X2P6_BRN-M; FUSE_SF-2410FP010T-2
HS_VOLT_GND: TP_S2751-46R
IC1: INA181A2IDBVTDBV0006A_L; SOT-23-6
IC2, IC6: TSV7721ILT; SOT-23-5
IC4: MAX6018AEUR16+T21-0051H_MXM-L; SOT-23
L1: PQ2617BHA-150K
LS_CURR_GND: TP_S2751-46R
LS_VOLT_GND: TP_S2751-46R
R1, R8, R42: Rf; RES_0603
R2: 10Ω; RES_0603
R3: 2Ω; RES_0603
R4, R5: 150kΩ; RES_0603
R6, R7: 82kΩ; RES_0603
R19: FCSL64R002GERRES_FCSL64_OHM-M; RES_FCSL64_OHM-M
R20: Rsnb; RES_0603
R36, R37: 10kΩ; RES_0603
R38, R39: 100kΩ; RES_0603
R40, R41: 22kΩ; RES_0603
R_SH1: WSL10203L000FEA; RES1020
SP1, SP2: SPACER_M6X25MM
TP_12V: TP_S2751-46R
TP_GND_IN: TP_S2751-46R
TP_HS_VOLT: TP_S2751-46R
TP_LS_VOLT: TP_S2751-46R
TP_LV_CURR: TP_S2751-46R
TP_PWM: TP_S2751-46R
U1: FDMF6820C
U3: TL071HIDBVRSOT23; TL071HIDBVR

Connections:
+3V3: C25.1, C29.1, D5.K, D6.K, D7.K, IC4.1 (IN), R36.2; also elsewhere on the board
+5V: C6.1, C13.1, C16.1, C18.1, C23.1, C57.1, C59.1, IC1.6 (V+), IC2.5 (VCC+), IC6.5 (VCC+), R2.2, U1.3 (VDRV), U3.5 (V+); also elsewhere on the board
+12V: C27.1, C36.1, C37.1, C38.1, C39.1, C40.1, C41.1, C42.1, C43.1, C44.1, C45.1, C46.1, C47.1, EC1.1 (+), EC9.1 (+), F1.2, R39.1, TP_12V.1, U1.9 (VIN), U1.10 (VIN_2), U1.11 (VIN_3), U1.12 (VIN_4), U1.13 (VIN_5), U1.14 (VIN_6), U1.42 (VIN_1); also elsewhere on the board
HS_VOLT: C58.1, D6.AK, R42.2, TP_HS_VOLT.1; also elsewhere on the board
LS_CURR: C21.1, D7.AK, R1.2, TP_LV_CURR.1; also elsewhere on the board
LS_VOLT: C7.1, D5.AK, R8.2, TP_LS_VOLT.1; also elsewhere on the board
unnamed: IC1.1 (OUT), R1.1
unnamed: C19.1, R3.2
unnamed: R3.1, U1.4 (BOOT)
unnamed: IC2.4 (IN-), R4.2, R7.1
unnamed: IC2.3 (IN+), R5.2, R6.2
unnamed: IC2.1 (OUT), R7.2, R8.1
unnamed: C28.1, R20.2
unnamed: IC6.4 (IN-), R38.2, R41.1
unnamed: IC6.3 (IN+), R39.2, R40.2
unnamed: IC6.1 (OUT), R41.2, R42.1
unnamed: R36.1, R37.2, U3.3 (IN+)
unnamed: F1.1, SP1.P$1
OUT_DISABLE: U1.39 (DISB-); also elsewhere on the board
PWM_OUT: TP_PWM.1, U1.40 (PWM); also elsewhere on the board
REF_1V65: C35.1, C48.1, IC1.5 (REF), IC4.2 (OUT), U3.1 (OUT), U3.4 (IN-)
SGND: C1.2, C2.2, C3.2, C4.2, C5.2, C6.2, C7.2, C8.2, C9.2, C10.2, C12.2, C13.2, C14.2, C15.2, C16.2, C17.2, C18.2, C21.2, C23.2, C25.2, C27.2, C28.2, C29.2, C35.2, C36.2, C37.2, C38.2, C39.2, C40.2, C41.2, C42.2, C43.2, C44.2, C45.2, C46.2, C47.2, C48.2, C57.2, C58.2, C59.2, D5.A, D6.A, D7.A, EC1.2 (-), EC2.2 (-), EC9.2 (-), HS_VOLT_GND.1, IC1.2 (GND), IC2.2 (VCC-), IC4.3 (GND), IC6.2 (VCC-), LS_CURR_GND.1, LS_VOLT_GND.1, R4.1, R6.1, R37.1, R38.1, R40.1, SP2.P$1, TP_GND_IN.1, U1.5 (CGND), U1.16 (PGND), U1.17 (PGND_2), U1.18 (PGND_3), U1.19 (PGND_4), U1.20 (PGND_5), U1.21 (PGND_6), U1.22 (PGND_7), U1.23 (PGND_8), U1.24 (PGND_9), U1.25 (PGND_10), U1.26 (PGND_11), U1.27 (PGND_12), U1.28 (PGND_13), U1.37 (CGND_1), U1.41 (CGND_2), U3.2 (V-); also elsewhere on the board
SW: C19.2, L1.2, R20.1, U1.7 (PHASE), U1.15 (VSWH), U1.29 (VSWH_2), U1.30 (VSWH_3), U1.31 (VSWH_4), U1.32 (VSWH_5), U1.33 (VSWH_6), U1.34 (VSWH_7), U1.35 (VSWH_8), U1.43 (VSWH_1)
THERMAL_WARN: U1.38 (THWN-); also elsewhere on the board
VCIN: C17.1, R2.1, U1.2 (VCIN)
V_BAT: IC1.4 (IN-), R5.1, R19.2, R_SH1.2
V_OUT: C1.1, C2.1, C3.1, C4.1, C5.1, C8.1, C9.1, C10.1, C12.1, C14.1, C15.1, EC2.1 (+), IC1.3 (IN+), L1.1, R19.1, R_SH1.1

Notes on the sheet:
High Side - Power Input
Mixed-type input capacitors: Up to 2 electrolytic capacitors and up to 12 MLCC 22uF / 0805.
Input fuse: 5A@4hours, 200% I_rated = 5sec
Mixed-type output capacitors. Electrolytic SMD + up to 11 MLCC 22uF /0805. It improves frequency response and reduces parasitics
DrMOS module. It includes driver and mosfet half-bridge. 27V@50A maximums capability.
High-Side and Low-Side Voltage monitors based on precision differential amplifiers
Low-Side range is 0-6V on battery terminals
High-Side range is 5.5-15V on battery terminals
Low-Side bidirectional current monitor: Based on INA181 and 3mO power shunt resistor Symmetrical charge / discharge current capability up to +-11A
EPC FRONT BOARD
REGENERATIVE EPC MAIN BOARD
IULIAN O. POPA
PABLO P. FLORES
REGEN. EPC

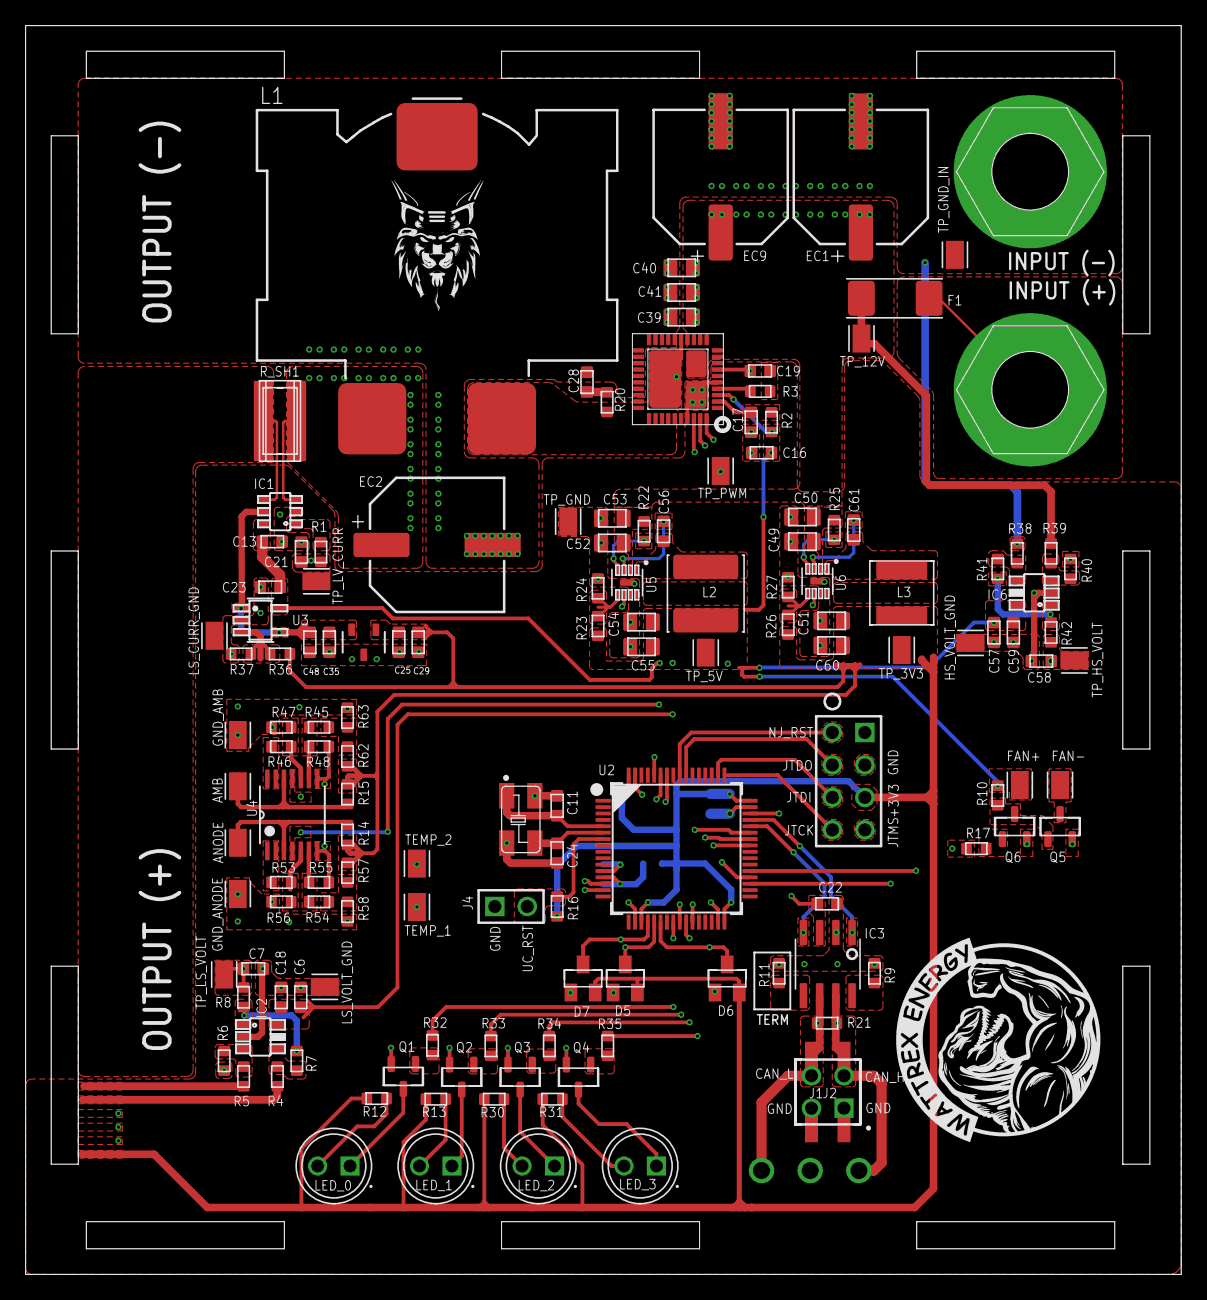
[picture p26: board EPC.brd from above]

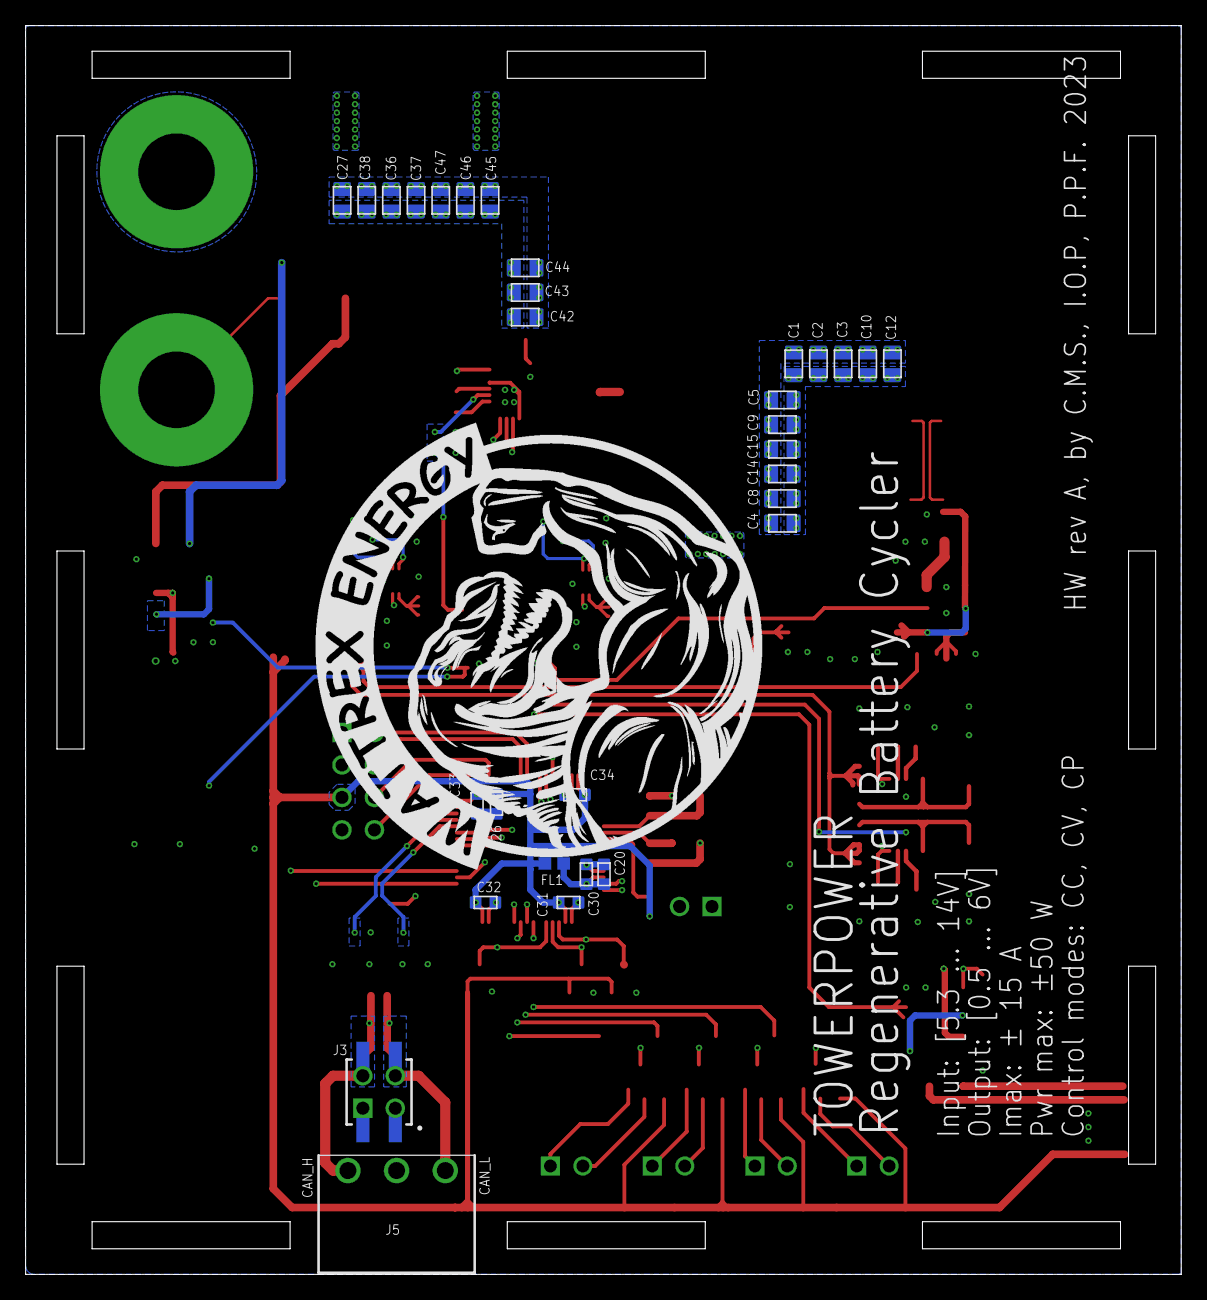
[picture p27: board EPC.brd from below]

Board: 4 copper layers, 90.5 x 97.8 mm, 174 parts (31 on the bottom side), 84 nets.
