WattRex/Regenerative-Battery-Cycler/doc/EPC/EPC_FRONTAL.brd

## EAGLE design doc/EPC/EPC_FRONTAL.brd (2023-09-15)

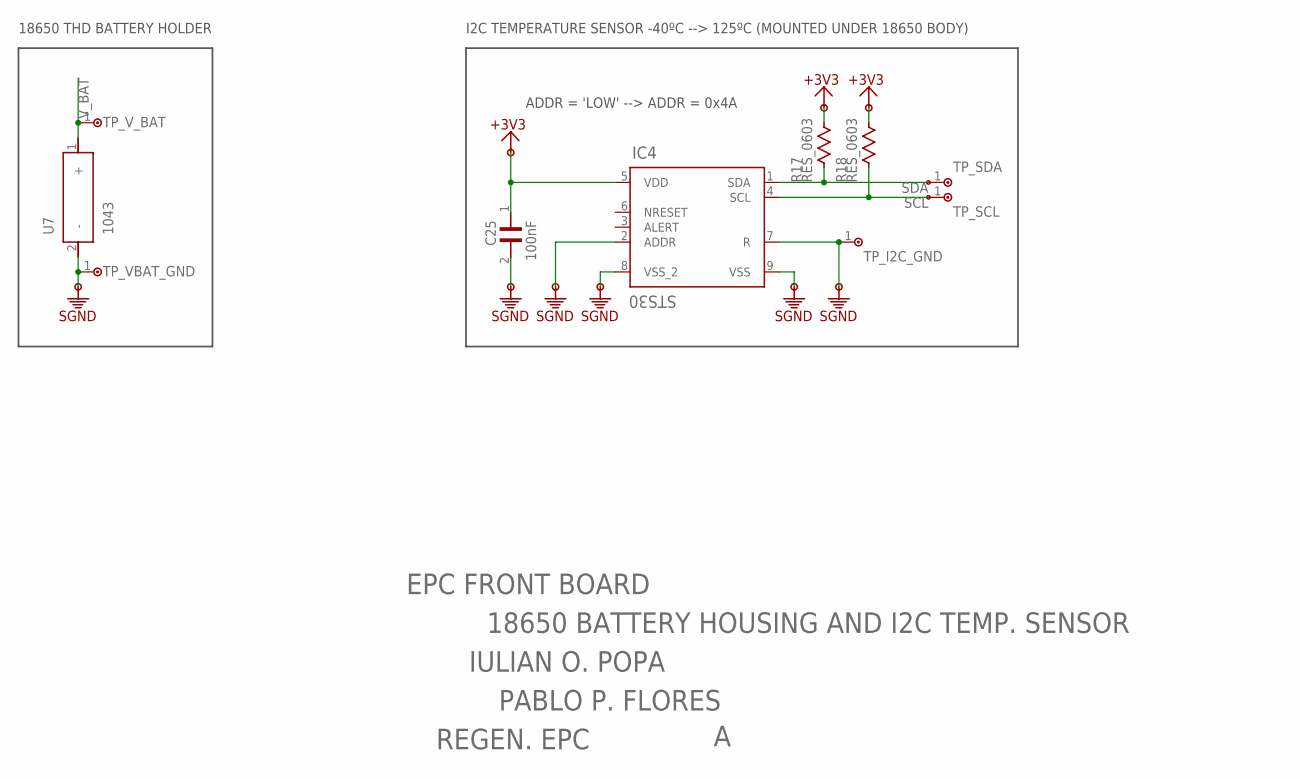
[picture p28: schematic EPC_FRONTAL.sch]

Parts:
C25: 100nF; CAP_0603
IC4: STS30; DFN
R17, R18: RES_0603
TP_I2C_GND: TP_S2751-46R
TP_SCL: TP_S2751-46R
TP_SDA: TP_S2751-46R
TP_VBAT_GND: TP_S2751-46R
TP_V_BAT: TP_S2751-46R
U7: 1043

Connections:
+3V3: C25.1, IC4.5 (VDD), R17.2, R18.2
SCL: IC4.4 (SCL), R18.1, TP_SCL.1
SDA: IC4.1 (SDA), R17.1, TP_SDA.1
SGND: C25.2, IC4.2 (ADDR), IC4.7 (R), IC4.8 (VSS_2), IC4.9 (VSS), TP_I2C_GND.1, TP_VBAT_GND.1, U7.2 (-)
V_BAT: TP_V_BAT.1, U7.1 (+)

Notes on the sheet:
ADDR = 'LOW' --> ADDR = 0x4A
18650 THD BATTERY HOLDER
I2C TEMPERATURE SENSOR -40ºC --> 125ºC (MOUNTED UNDER 18650 BODY)
EPC FRONT BOARD
18650 BATTERY HOUSING AND I2C TEMP. SENSOR
IULIAN O. POPA
PABLO P. FLORES
REGEN. EPC

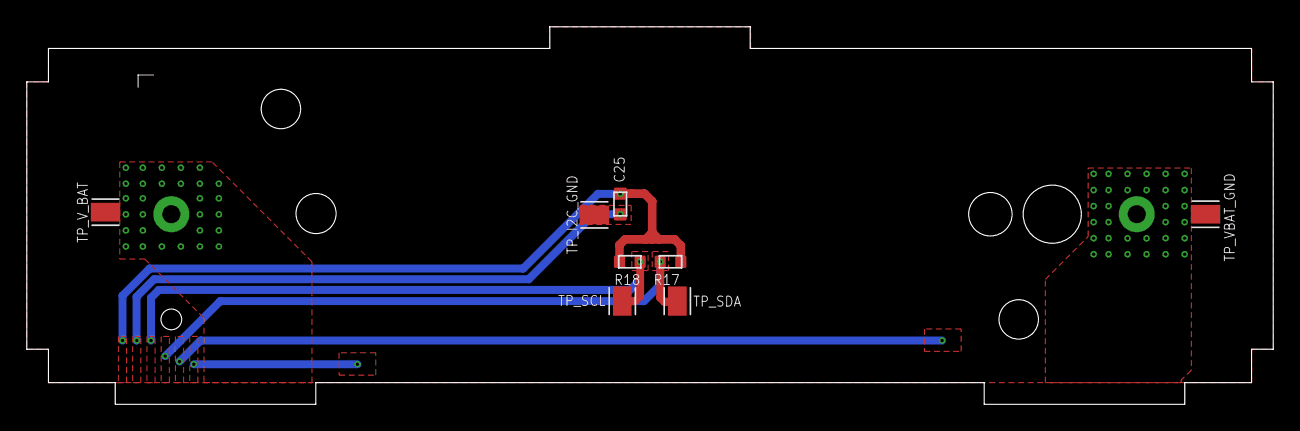
[picture p29: board EPC_FRONTAL.brd from above]

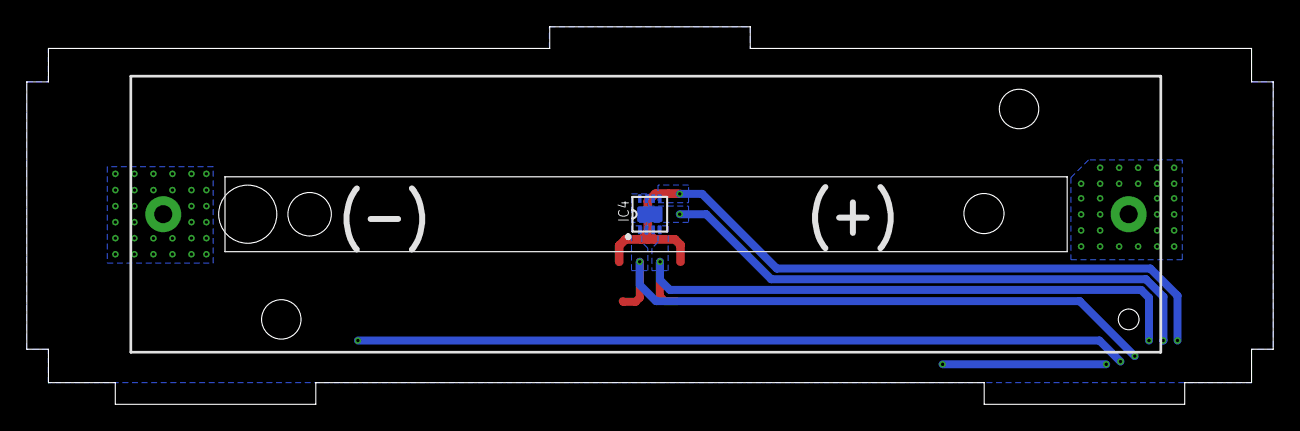
[picture p30: board EPC_FRONTAL.brd from below]

Board: 4 copper layers, 93.2 x 28.2 mm, 10 parts (2 on the bottom side), 5 nets.
