WattRex/Regenerative-Battery-Cycler/(commit log)

2023-06-02 Updated ADC
2023-06-02 leds status machine logic added
2023-06-06 MID_DABS leds conf and first version of MID_REG added
2023-06-07 Change interface of CAN and STS, also naming conventions in GPIO and PWM
2023-06-26 Added activity flow of HAL_PWM and STS
2023-06-27 Electrical cad added
2023-06-30 Update activity flow
2023-06-30 Update activity flow HAL_SYS
2023-07-10 Update timing diagram and changes in leds to follow the direction of current
2023-07-13 change in leds for hs and ls volt error
2023-09-15 Hardware project files
    [EPC.brd, EPC.sch, EPC_FAN.brd, EPC_FRONTAL.brd, EPC_FRONTAL.sch, EPC_FRONTAL_ALT.brd, EPC_FRONTAL_ALT.sch, EPC_LATERAL.brd]
