WattRex/Regenerative-Battery-Cycler/(notices)

Notices in the files:
parts and their libraries:
EPC_V2: COPYRIGHT: Copyright (C) 2022 Ultra Librarian. All rights reserved.
EPC_V2: COPYRIGHT: Copyright (C) 2023 Ultra Librarian. All rights reserved.
